jianweizou/fun/doc/電源接頭的位置按要上移6.4MM 右移3.85MM     image007.png

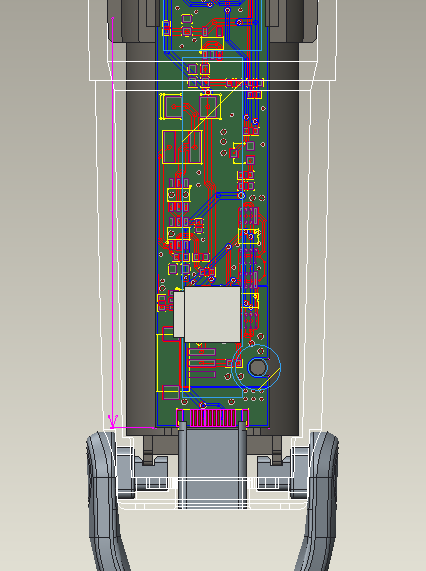
doc/電源接頭的位置按要上移6.4MM 右移3.85MM image007.png
