jianweizou/fun/README.md

# fun
fun

list:
20190226：
1、电源睡眠后电流大，4mA，电流大是由于AMS1117-33 LDO消耗大，需要替换为低功耗的
2、线路图中电池电压检测分压电阻是1：2
3、U7要去掉？
