jianweizou/fun/code/sonix evb/3.SN7312_IIC_OLED/src/29512885_1493619394BfCq.png

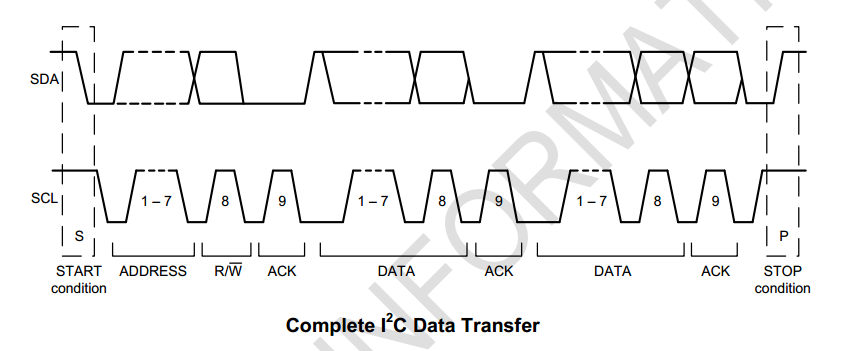
code/sonix evb/3.SN7312_IIC_OLED/src/29512885_1493619394BfCq.png
