jianweizou/fun/doc/fan 20181207/USB TYPE C 3.1母座夹板间距1.0MM 长度10.5MM工程图.jpg

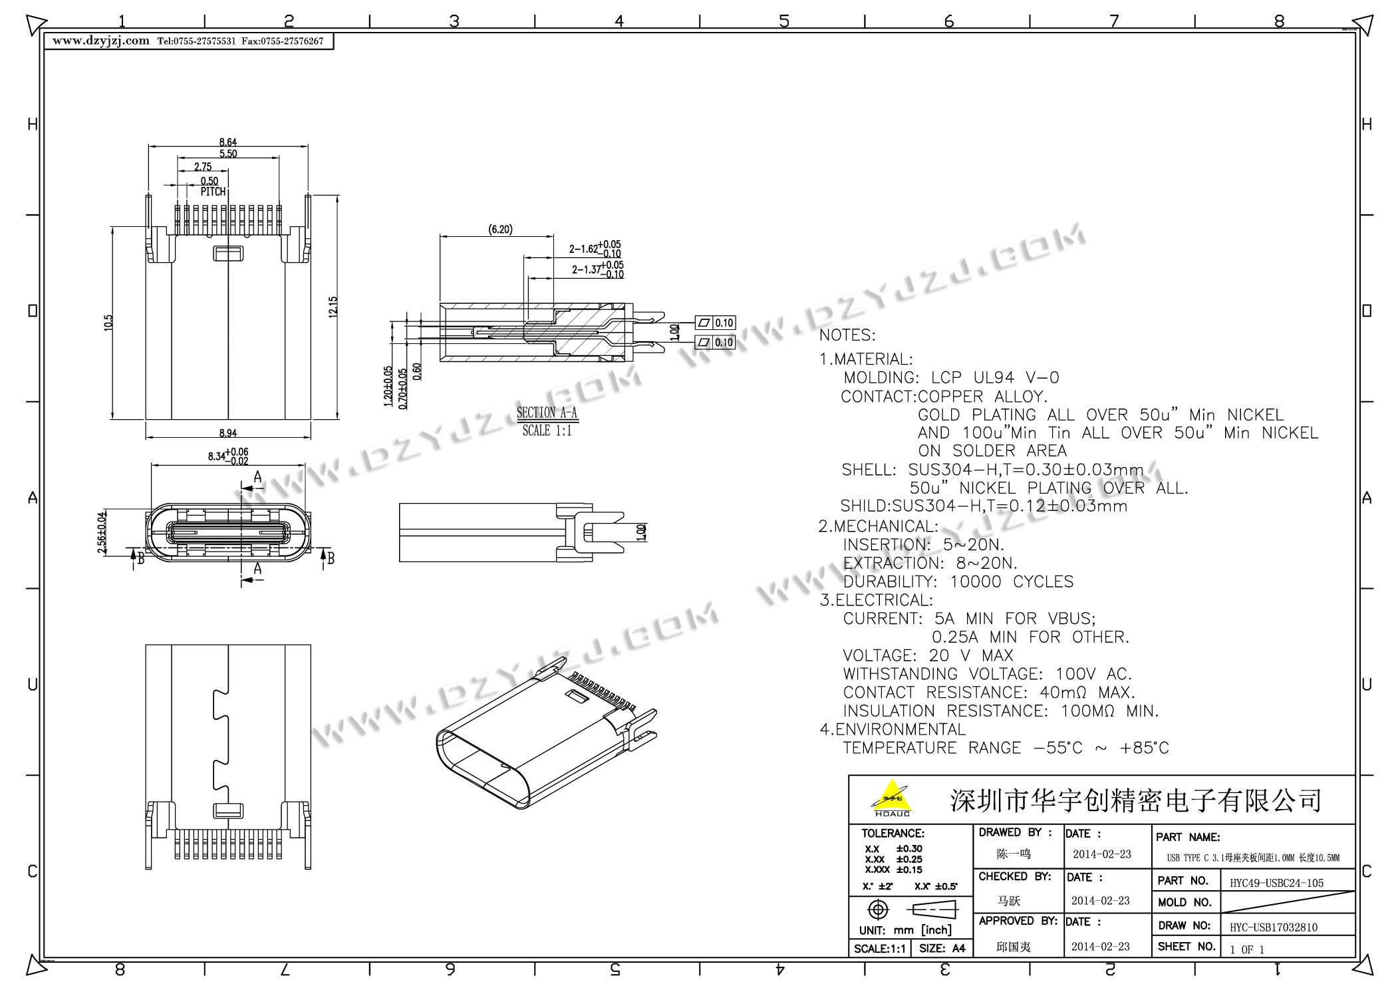
doc/fan 20181207/USB TYPE C 3.1母座夹板间距1.0MM 长度10.5MM工程图.jpg
