jianweizou/fun/doc/FAN/image001.png

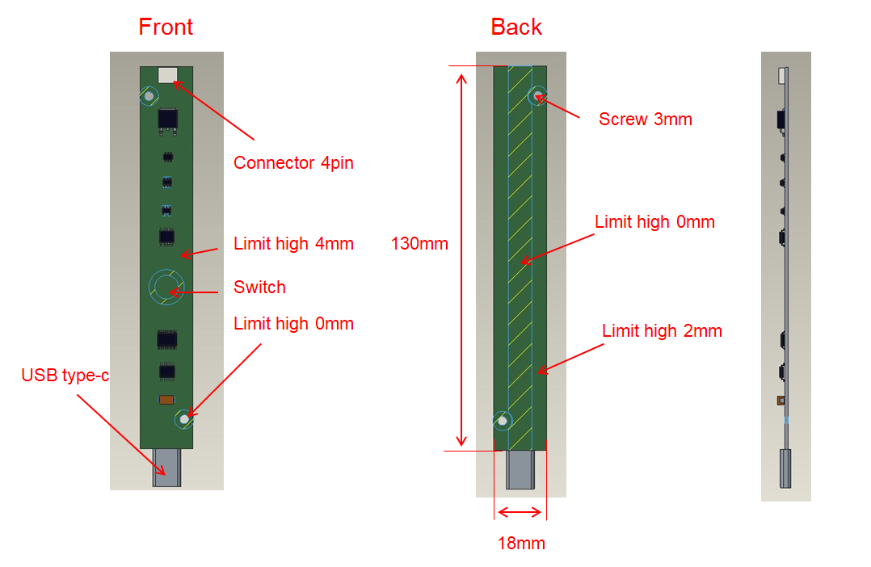
doc/FAN/image001.png
