jianweizou/fun/doc/image001.png

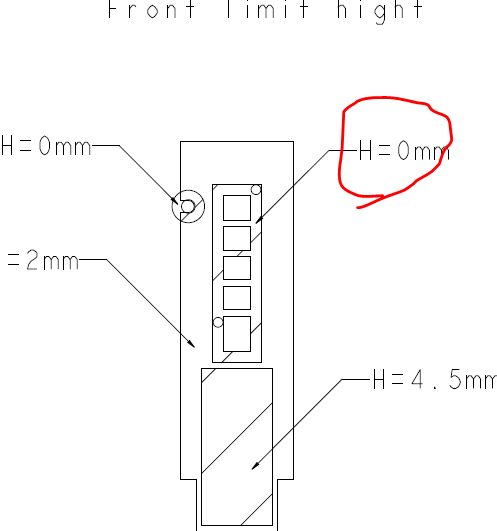
doc/image001.png
