jianweizou/fun/doc/image002.png

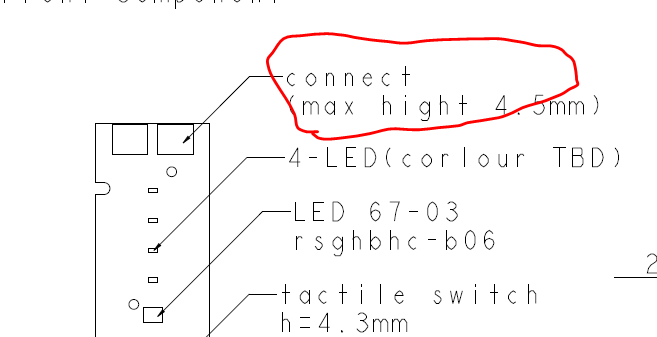
doc/image002.png
