jianweizou/fun/doc/左上角的螺絲孔跟零件有重疊要閃開image008.png

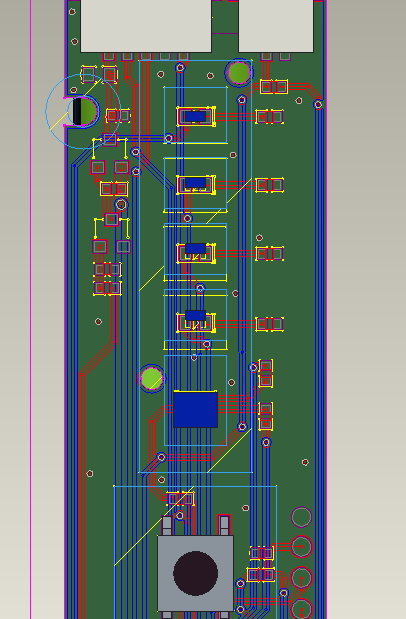
doc/左上角的螺絲孔跟零件有重疊要閃開image008.png
