jianweizou/fun/layout/风扇_V1.9_20190731/风扇_V1.9.xls

风扇_V1.8
Comment | Designator | Footprint | Quantity | Name
47uF | C1, C3 | C-0603 | 2
22uF | C2, C6, C7 | C-0603 | 3
4.7uF | C4 | C-0402 | 1
1uF | C5, C8, C9, C11, C12 | C-0402 | 5
0.1uF | C10 | C-0402 | 1
10K | R1, R3, R4, R27, R28, R30, R31, R32, R33 | R-0402 | 9 | 贴片电阻
60K | R2 | R-0402 | 1
1K | R5,R8 | R-0402 | 2
330R | R6, R11 | R-0402 | 2
0.1R | R7 | R-0402 | 1
470K | R9 | R-0402 | 1
4.7K | R10 | R-0402 | 1
2K | R12 | R-0402 | 1
500R | R15, R16, R17, R18, R19, R20, R21 | R-0402 | 7
47K | R22, R23, R26 | R-0402 | 3
500K | R25 | R-0402 | 1
1M | R24 | R-0402 | 1
20K | R29 | R-0402 | 1
LED0 | D1, D3, D4, D5 | LED-0603 | 4 | 贴片LED
LED | D2 | 0603 RGB-LED | 1 | RGB 共阴 LED | 封装参考：https://item.taobao.com/item.htm?id=577033877168&ns=1&abbucket=5
10uH 1A or 2A | L1 | L-SMD | 1 | 贴片电感（4*4*2mm）
TU1501WNR-5PS-VOID-C0-NL-A | P2 | TU1501WNR-5PS-VOID-C0-NL-A | 1 | TU1501WNR-5PS-VOID-C0-NL-A | 封装参考：http://www.tyu.com.tw/en/search_detail.php?cid=1&cid2=3&cid3=8&nid=50&s_ok2=2&Page=0
TU1501WNR-3PS-VOID-C0-NL-A | P1 | TU1501WNR-3PS-VOID-C0-NL-A | 1 | TU1501WNR-3PS-VOID-C0-NL-A | 封装参考：http://www.tyu.com.tw/en/search_detail.php?cid=1&cid2=3&cid3=8&nid=50&s_ok2=2&Page=0
TU1501WNR-2PS-VOID-C0-NL-A | P3 | TU1501WNR-2PS-VOID-C0-NL-A | 1 | TU1501WNR-2PS-VOID-C0-NL-A | 封装参考：http://www.tyu.com.tw/en/search_detail.php?cid=1&cid2=3&cid3=8&nid=50&s_ok2=2&Page=0
8050 | Q1, Q3, Q6, Q7 | SOT-23 | 4 | 8050 NPN 三极管
BM2301 | Q2, Q4 | SOT-23 | 2 | BM2312 PMOS
8550 | Q5 | SOT-23 | 1
SW-PB | S1 | SWITHCH-4P-SMT | 1 | 四角按键6*6*4.3mm
TPS76033DBVR | U4 | SOT-223 | 1 | IC
USB Type-C | U5 | USB-type C | 1 | USB-type C
N76E003AQ20 | U6 | QFN-20 0.4mm | 1 | IC
HY2120-CB | U1 | SOT-23-6L | 1 | HY2120
HM4033 | U2 | SOT-23-6L | 1 | HM4033
8205A | U3 | TSSOP8 | 1 | 8205A
HM8205-6 | U8 | SOT-23-6L | 1 | HM8205-6
SS34 | D6 | DSMD | 1 | SS34 二极管 | 注意方向
