jianweizou/fun/doc/to 鄒生 main_board_pcb_20190411_v3.dxf

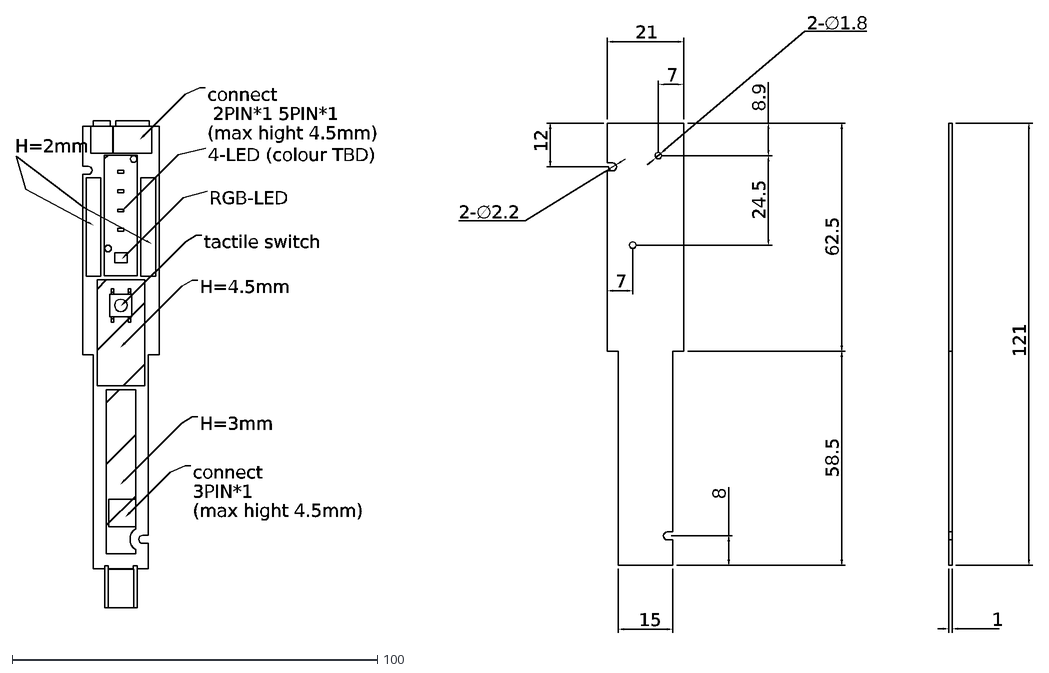
[picture p9: CAD file, 2019-05-01]
doc/to 鄒生 main_board_pcb_20190411_v3.dxf
21
12
8
15
121
62.5
58.5
2-∅1.8
8.9
24.5
7
1
2-∅2.2
connect
2PIN*1 5PIN*1
(max hight 4.5mm)
4-LED (colour TBD)
tactile switch
RGB-LED
H=3mm
H=4.5mm
H=2mm
3PIN*1
