jianweizou/fun/layout/风扇_V1.4_20190213/风扇_V1.4.DXF

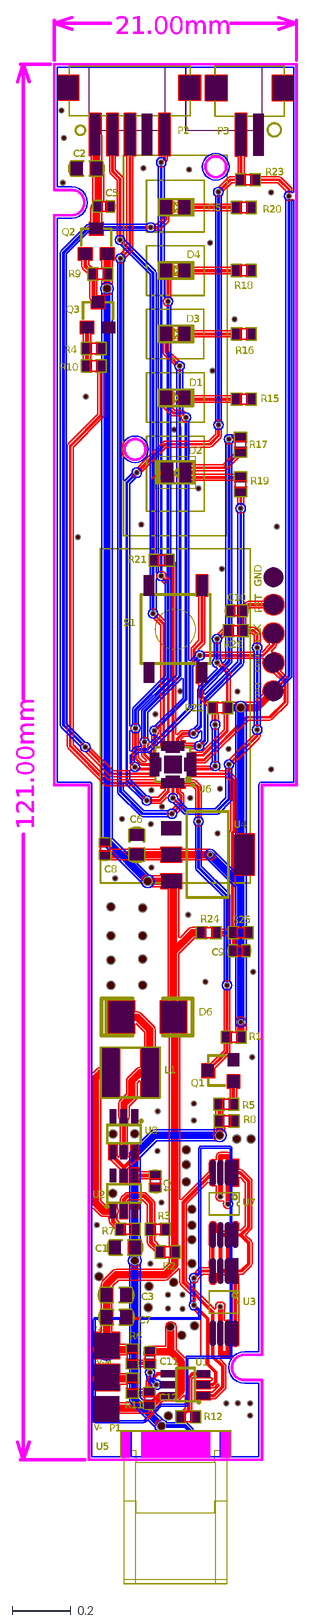
[picture p10: CAD file, 2019-02-16]
layout/风扇_V1.4_20190213/风扇_V1.4.DXF
DAT
BAT
CLK
RST
GND
V+
V-
V-M
21.00mm
121.00mm
U6
U5
U4
U3
U2
U1
S1
R26
R25
R24
R23
R22
R21
R20
R19
R18
R17
R16
R15
R12
R11
R10
R9
R8
R6
R5
R4
R3
R2
R1
Q1
P3
P2
P1
L1
D2
C10
C9
C8
C7
C6
C5
C4
C3
C2
C1
D1
D3
D4
D5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
