jianweizou/fun/layout/风扇_V1.6_20190413/风扇_V1.DXF

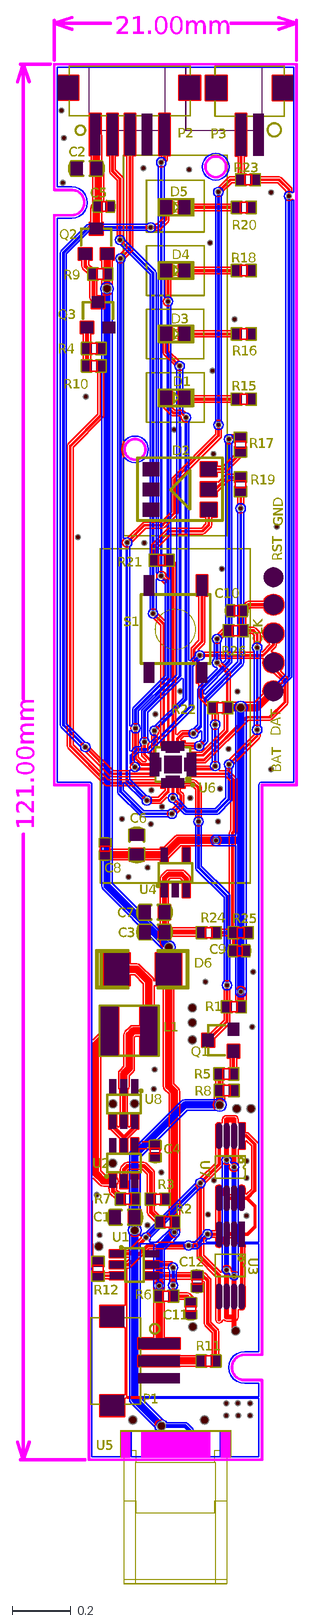
[picture p12: CAD file, 2019-04-13]
layout/风扇_V1.6_20190413/风扇_V1.DXF
GND
RST
CLK
BAT
DAT
121.00mm
21.00mm
U8
U7
Q3
Q2
D6
C12
C11
R7
D5
D4
D3
D1
C1
C2
C3
C4
C5
C6
C7
C8
C9
C10
D2
L1
P1
P2
P3
Q1
R1
R2
R3
R4
R5
R6
R8
R9
R10
R11
R12
R15
R16
R17
R18
R19
R20
R21
R22
R23
R24
R25
R26
S1
U1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
