jianweizou/fun/layout/风扇_V1.9_20190731/风扇_V1.9.DXF

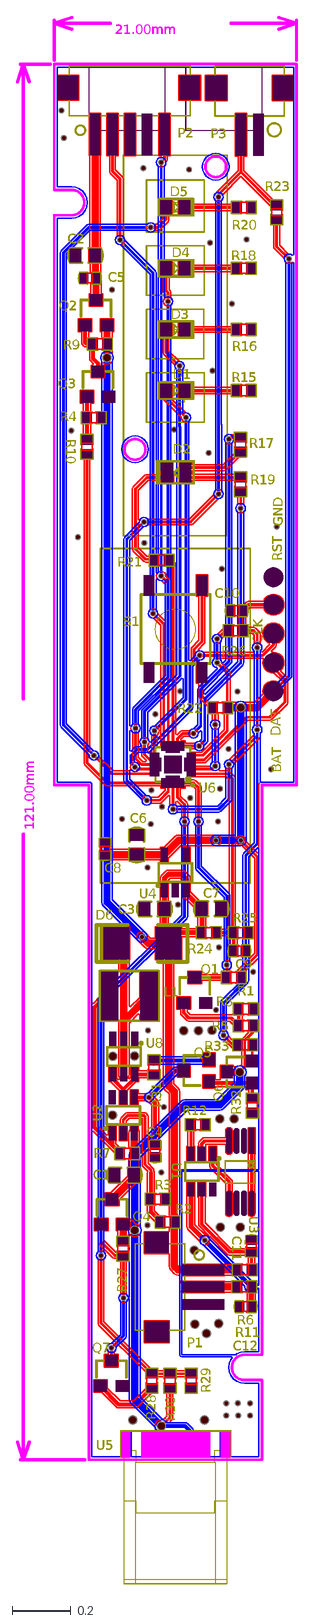
[picture p15: CAD file, 2019-09-28]
layout/风扇_V1.9_20190731/风扇_V1.9.DXF
DAT
BAT
CLK
RST
GND
21.00mm
121.00mm
Q7
R33
R32
R31
Q6
Q5
R30
R29
R28
R27
Q4
R6
C12
U6
U5
U4
U3
U2
U1
S1
R26
R25
R24
R23
R22
R21
R20
R19
R18
R17
R16
R15
R12
R11
R10
R9
R8
R5
R4
R3
R2
R1
Q1
P3
P2
P1
L1
D2
C10
C9
C8
C7
C6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
