jianweizou/fun/(list of files, cad)

Other CAD files:
code/fun_20180702/Output/main.obj
doc/fan 20181207/main_board_pcb_v1.dxf
doc/main_board_pcb_v1with 2CNTand 3pad.dxf
code/fun_20180702/Output/motor.obj
code/fun_20180702/Output/key.obj
code/fun_20180702/Output/led.obj
code/fun_20180702/Output/STARTUP.obj
code/fun_20180702/Output/PUTCHAR.obj
