jianweizou/fun/layout/风扇_V1.8_20190429/风扇_V1.8.pdf

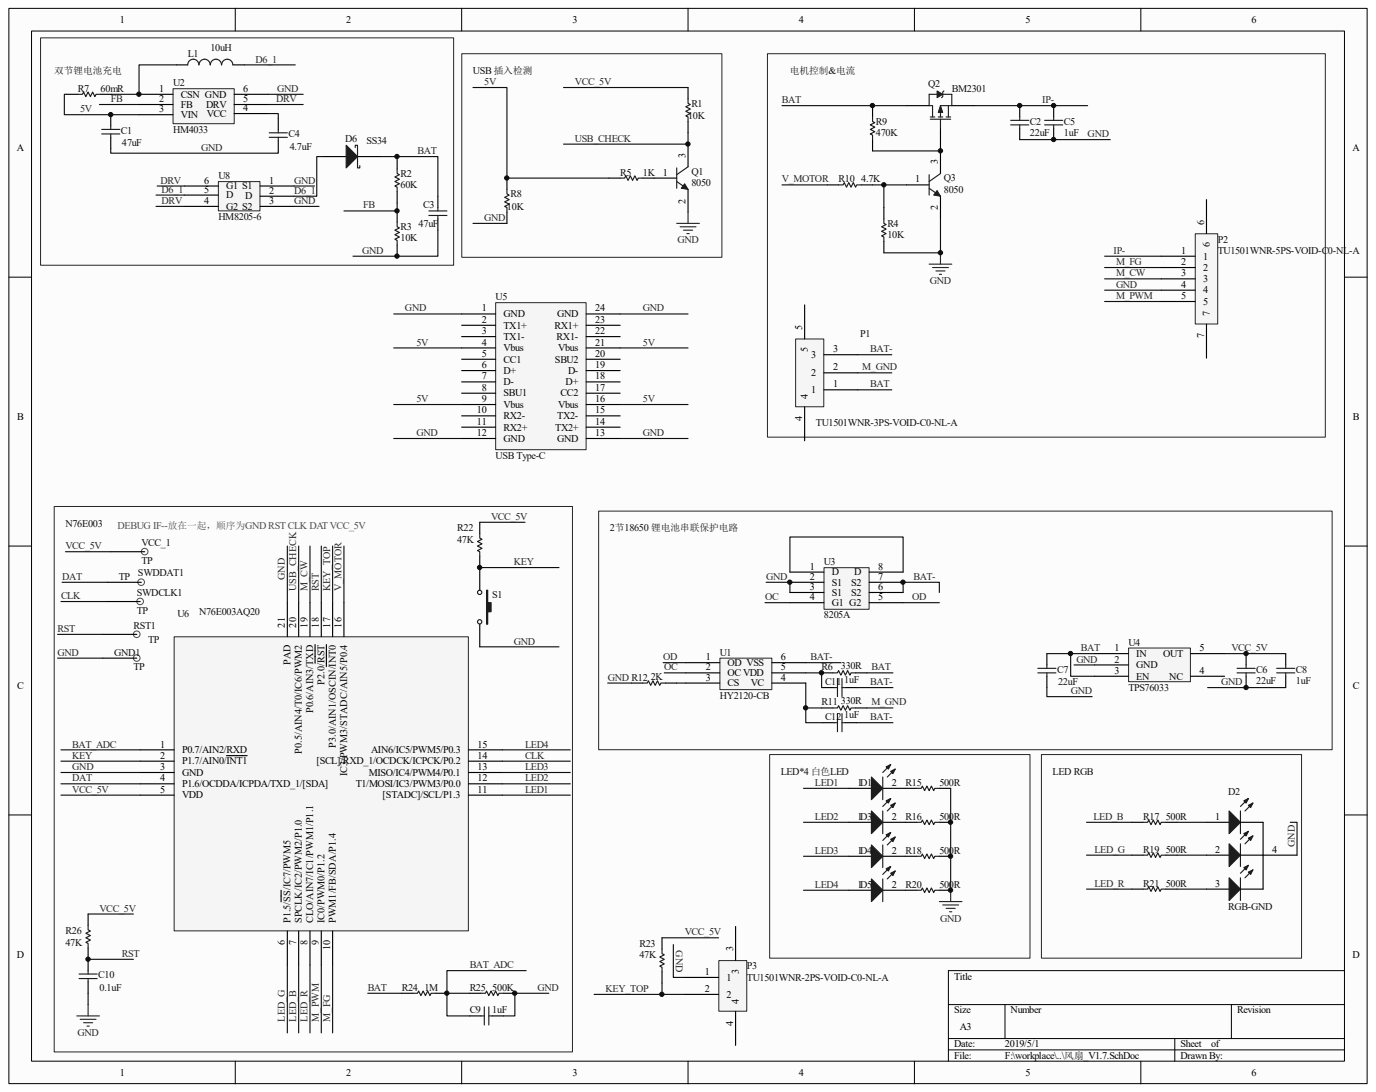
[picture p19: page 1]

IP- P⁰.5/AIN⁴/T⁰/IC⁶/PWM² ²⁰ P⁰.6/AIN³/TXD ¹⁹

DEBUG IF--放在一起，顺序为GND RST CLK DAT VCC_5V
VCC_1
