jianweizou/fun/doc/fan 20181207/main_board_pcb_v1.pdf

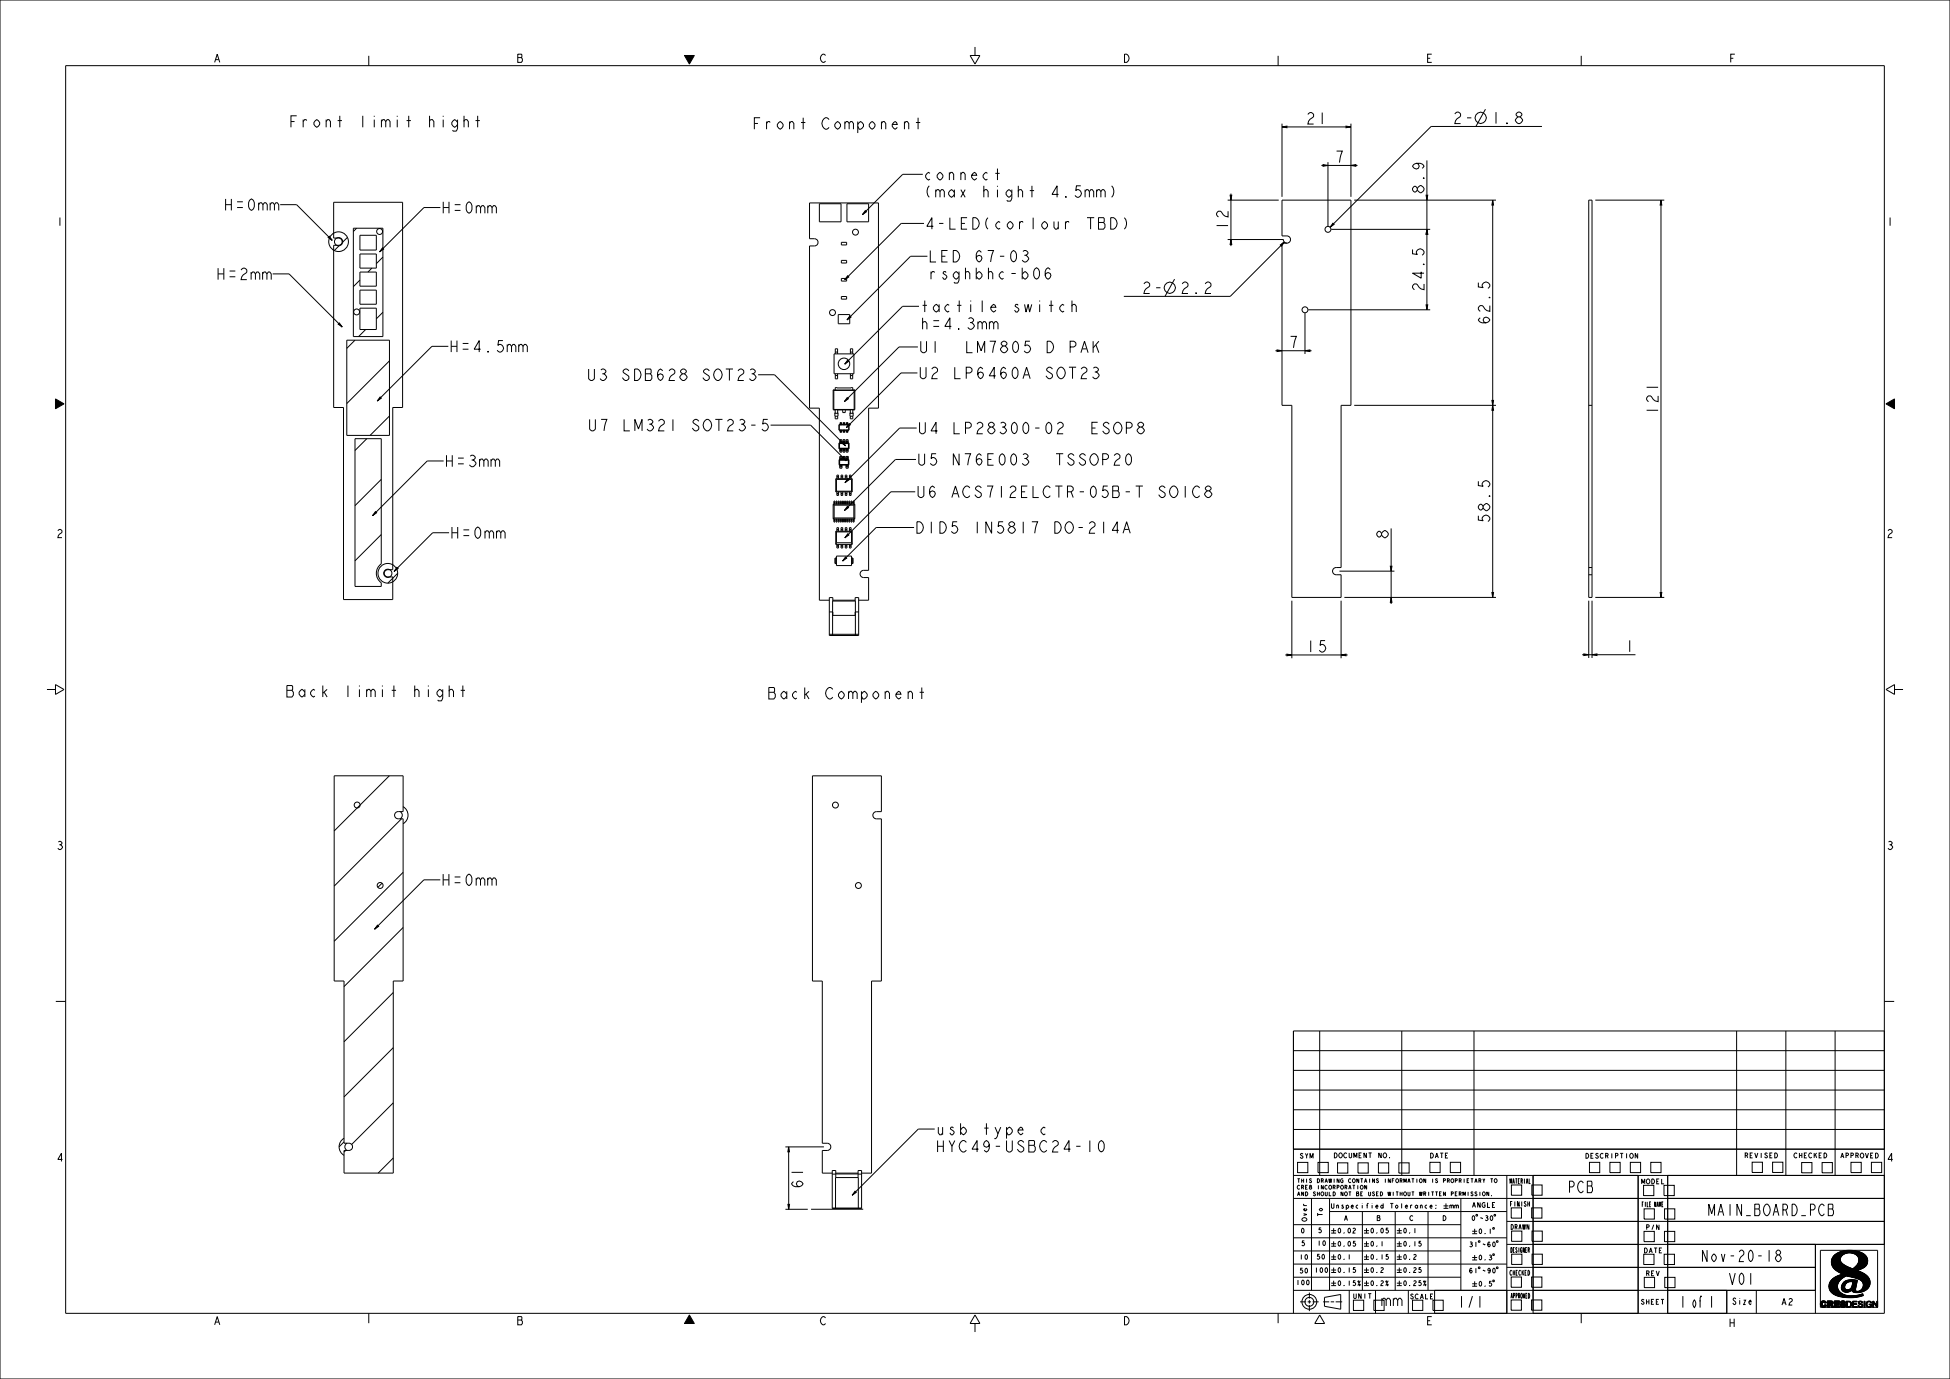
[picture p21: page 1]
Unspecified Tolerance: #-; ANGLE; F Over; DESIGNER; APPROVED; CHECKED; FINISH; MATERIAL; FILE NAME; MODEL; SHEET; DATE; UNIT; SCALE; SYM; DOCUMENT; DESCRIPTION; REVISED; Front; limit hight; Back; limit; hight; usb type; HYC49-USBC24-10; connect; (max hight; 4-LED(corlour TBD); tactile; switch; h=4.3mm U1 LM7805 D PAK; U3 SDB628 SOT23; U2 LP6460A SOT23; U7 LM321 SOT23-5; U4 LP28300-02 ESOP8; U5 N76E003 TSSOP20 U6 ACS712ELCTR-05B-T SOIC8 D1D5 1N5817 DO-214A; Component; LED 67-03 rsghbhc-b06

THIS DRAWING CONTAINS INFORMATION IS PROPRIETARY TO CRE8 INCORPORATION AND SHOULD NOT BE USED WITHOUT WRITT EN PERMISSION. | PCB

MAIN_BOARD_PCB
Nov-20-18

5 | | | | | | | | 31$-
50
50 | | | | | | | 61$-

DRAWN | P/N

REV

Size
