jianweizou/fun/doc/TO 鄒生 main_board_pcb_20190411_v3.pdf

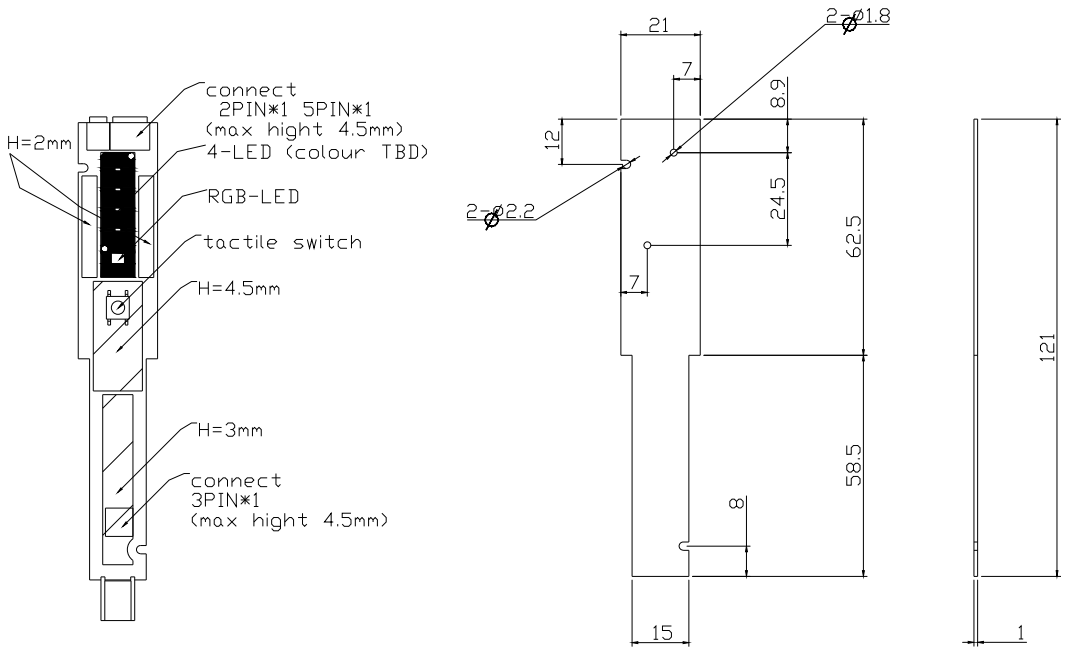
[picture p22: page 1]
