jianweizou/fun/doc/13H 12V Drawing.pdf

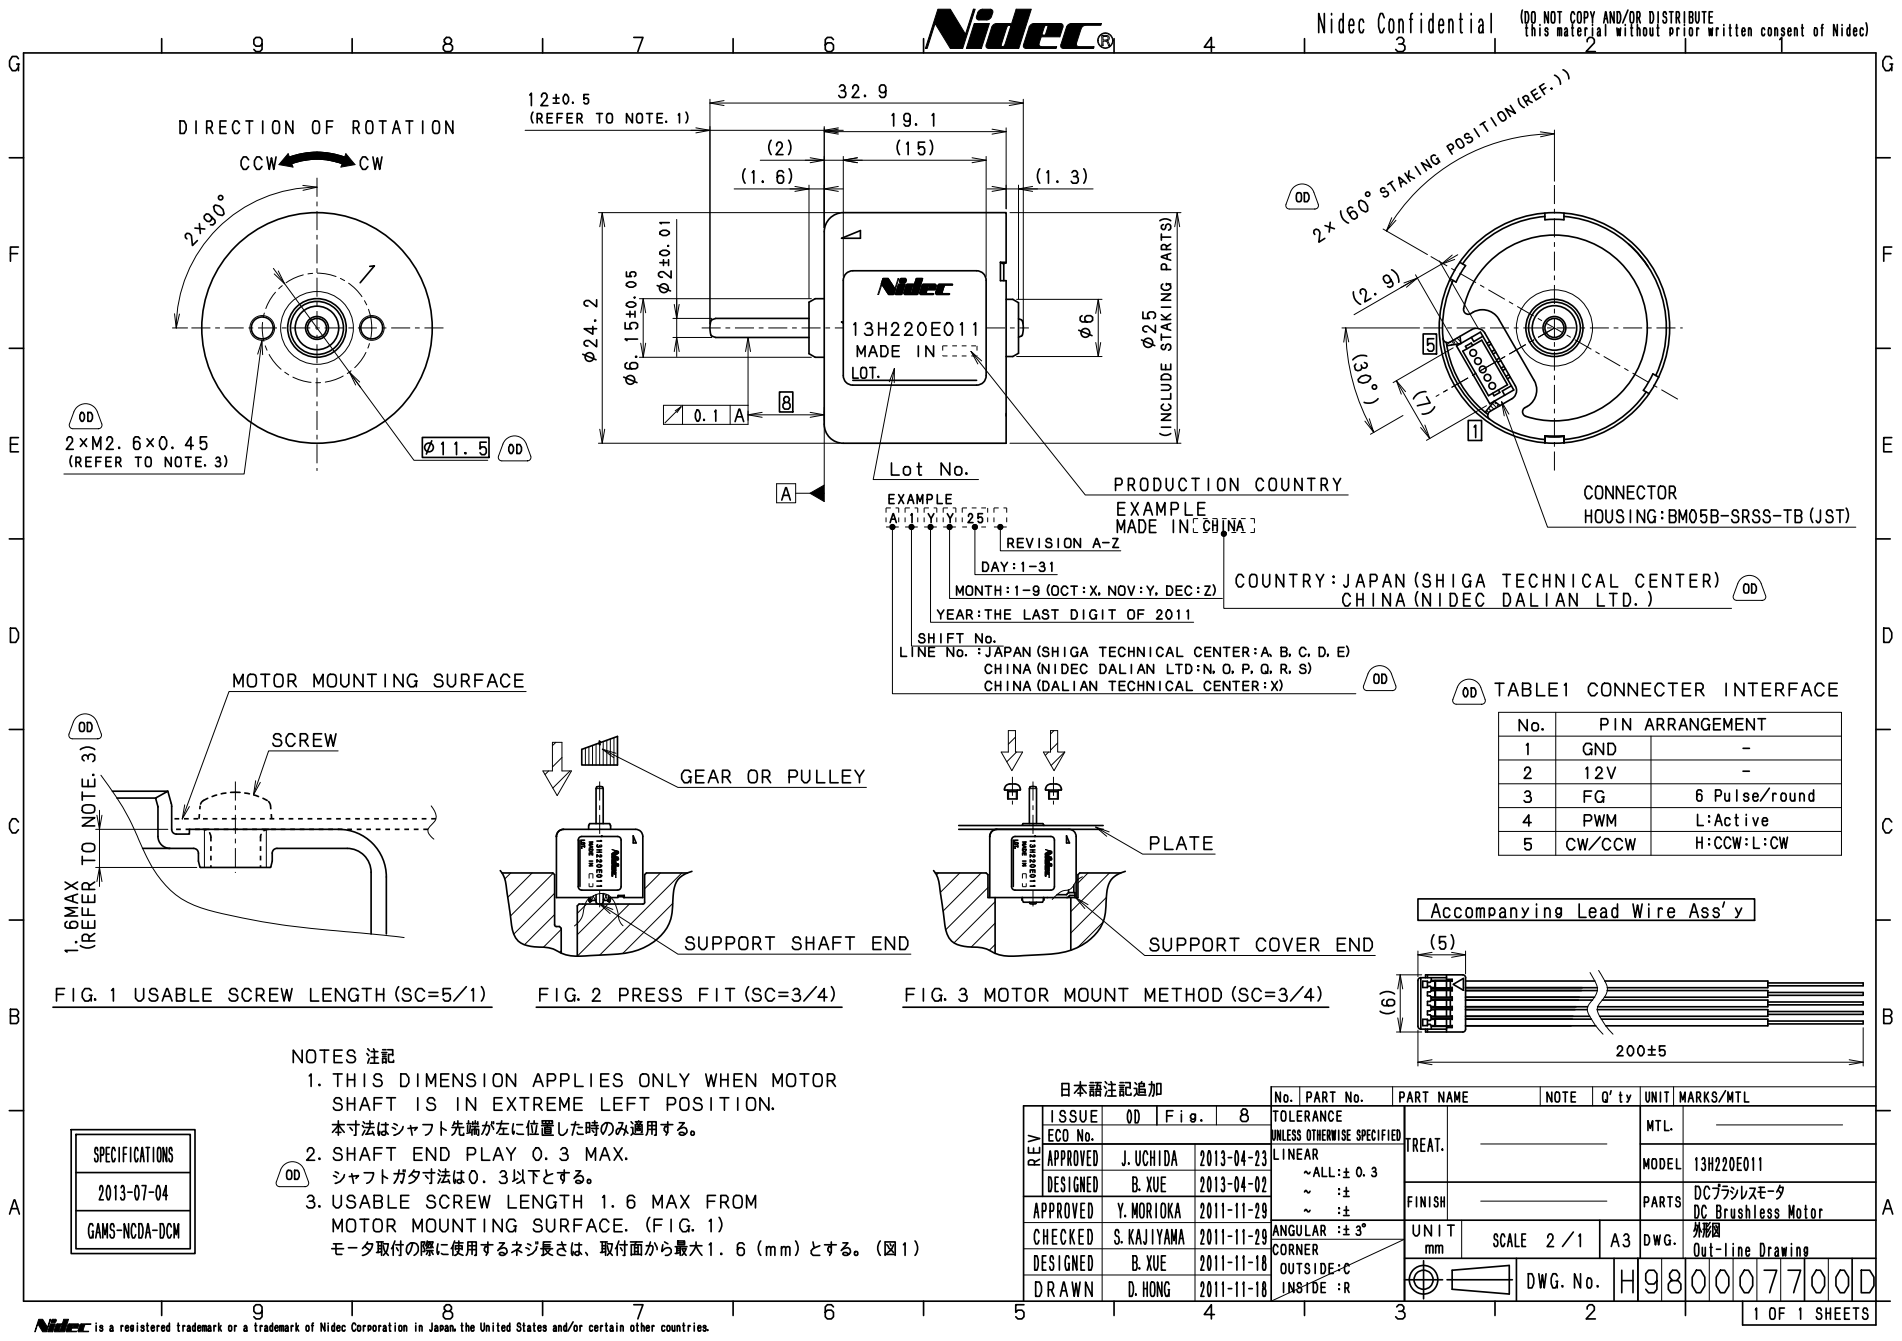
[picture p23: page 1]
