jianweizou/fun/doc/EN-TU1501HNO-NP-x.pdf

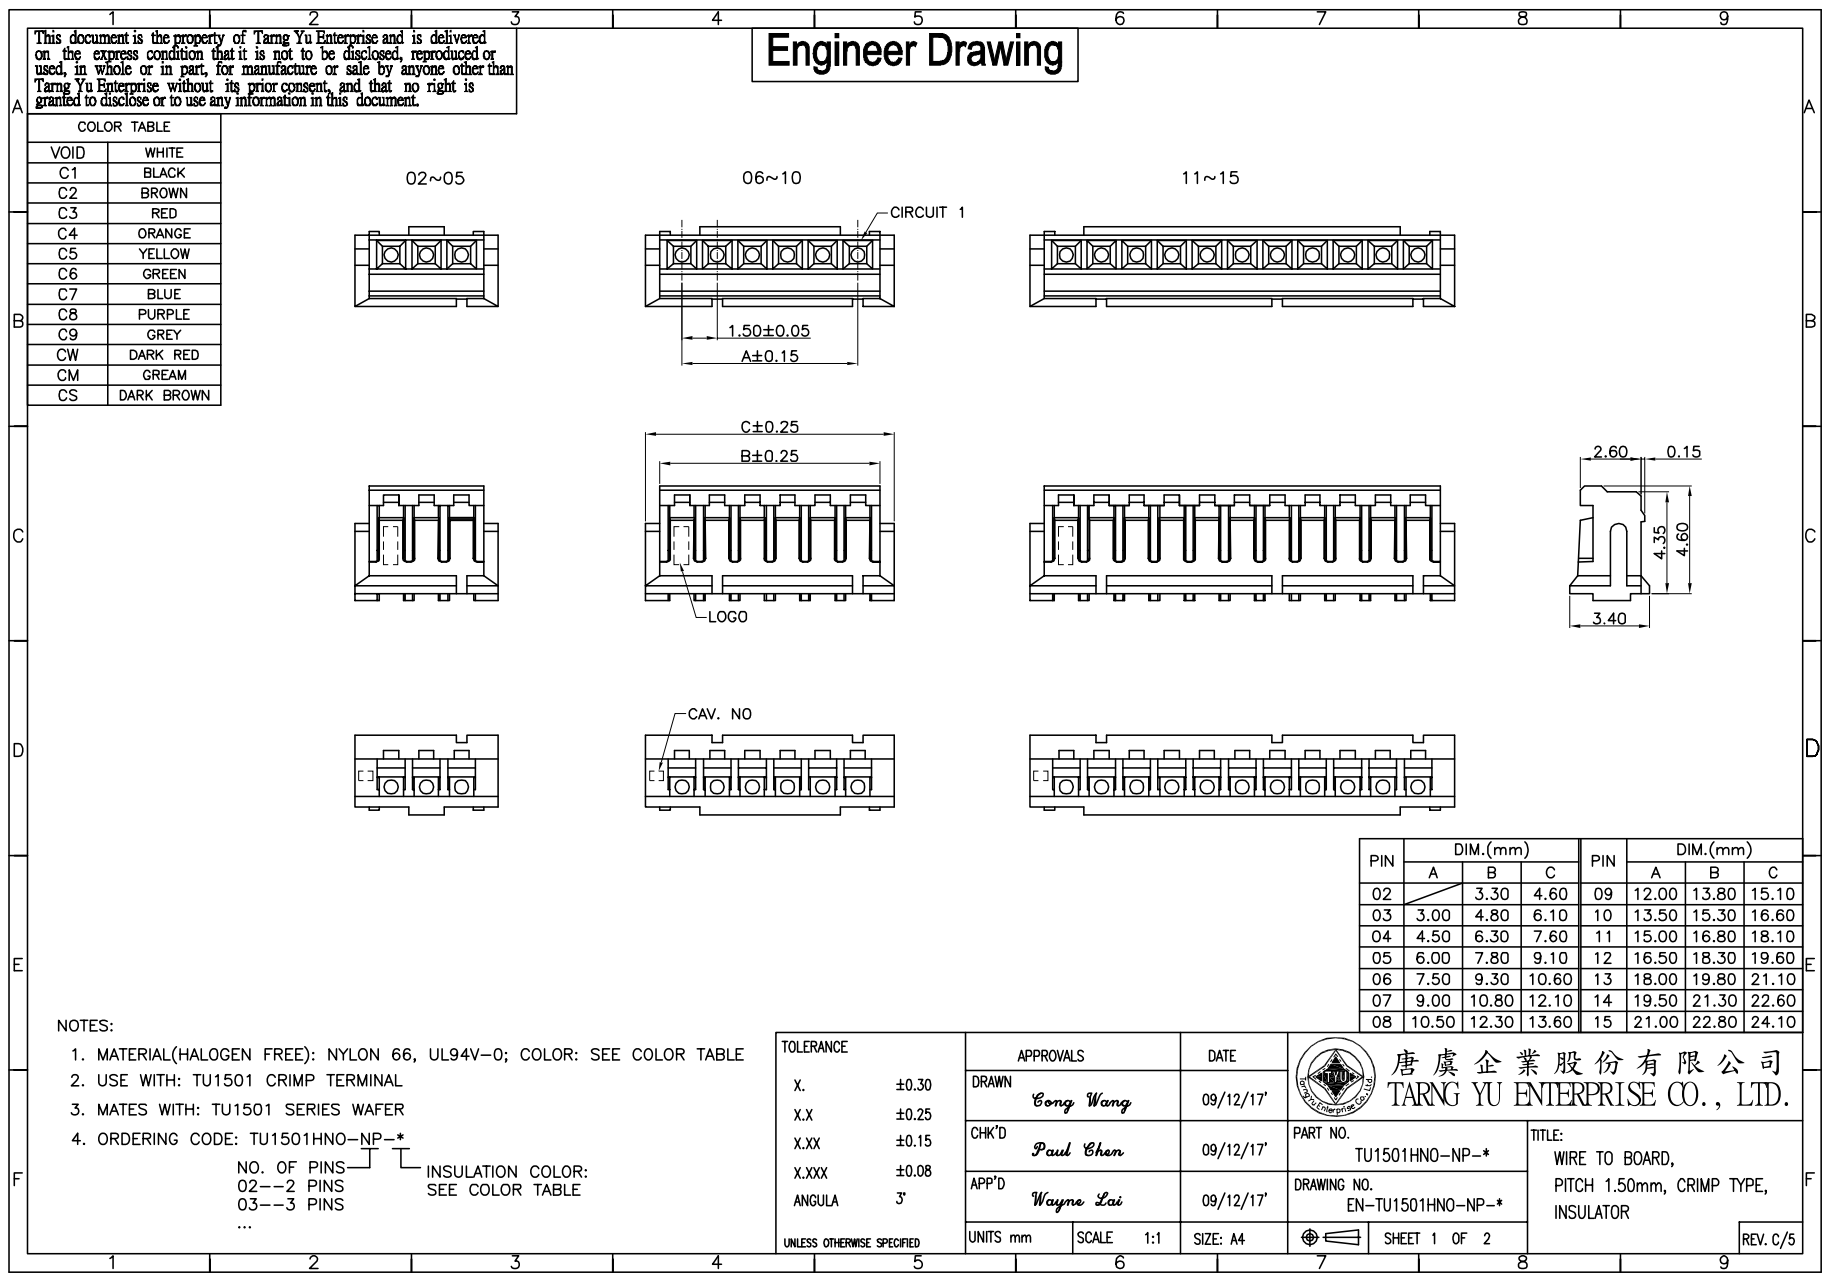
[picture p24: page 1]

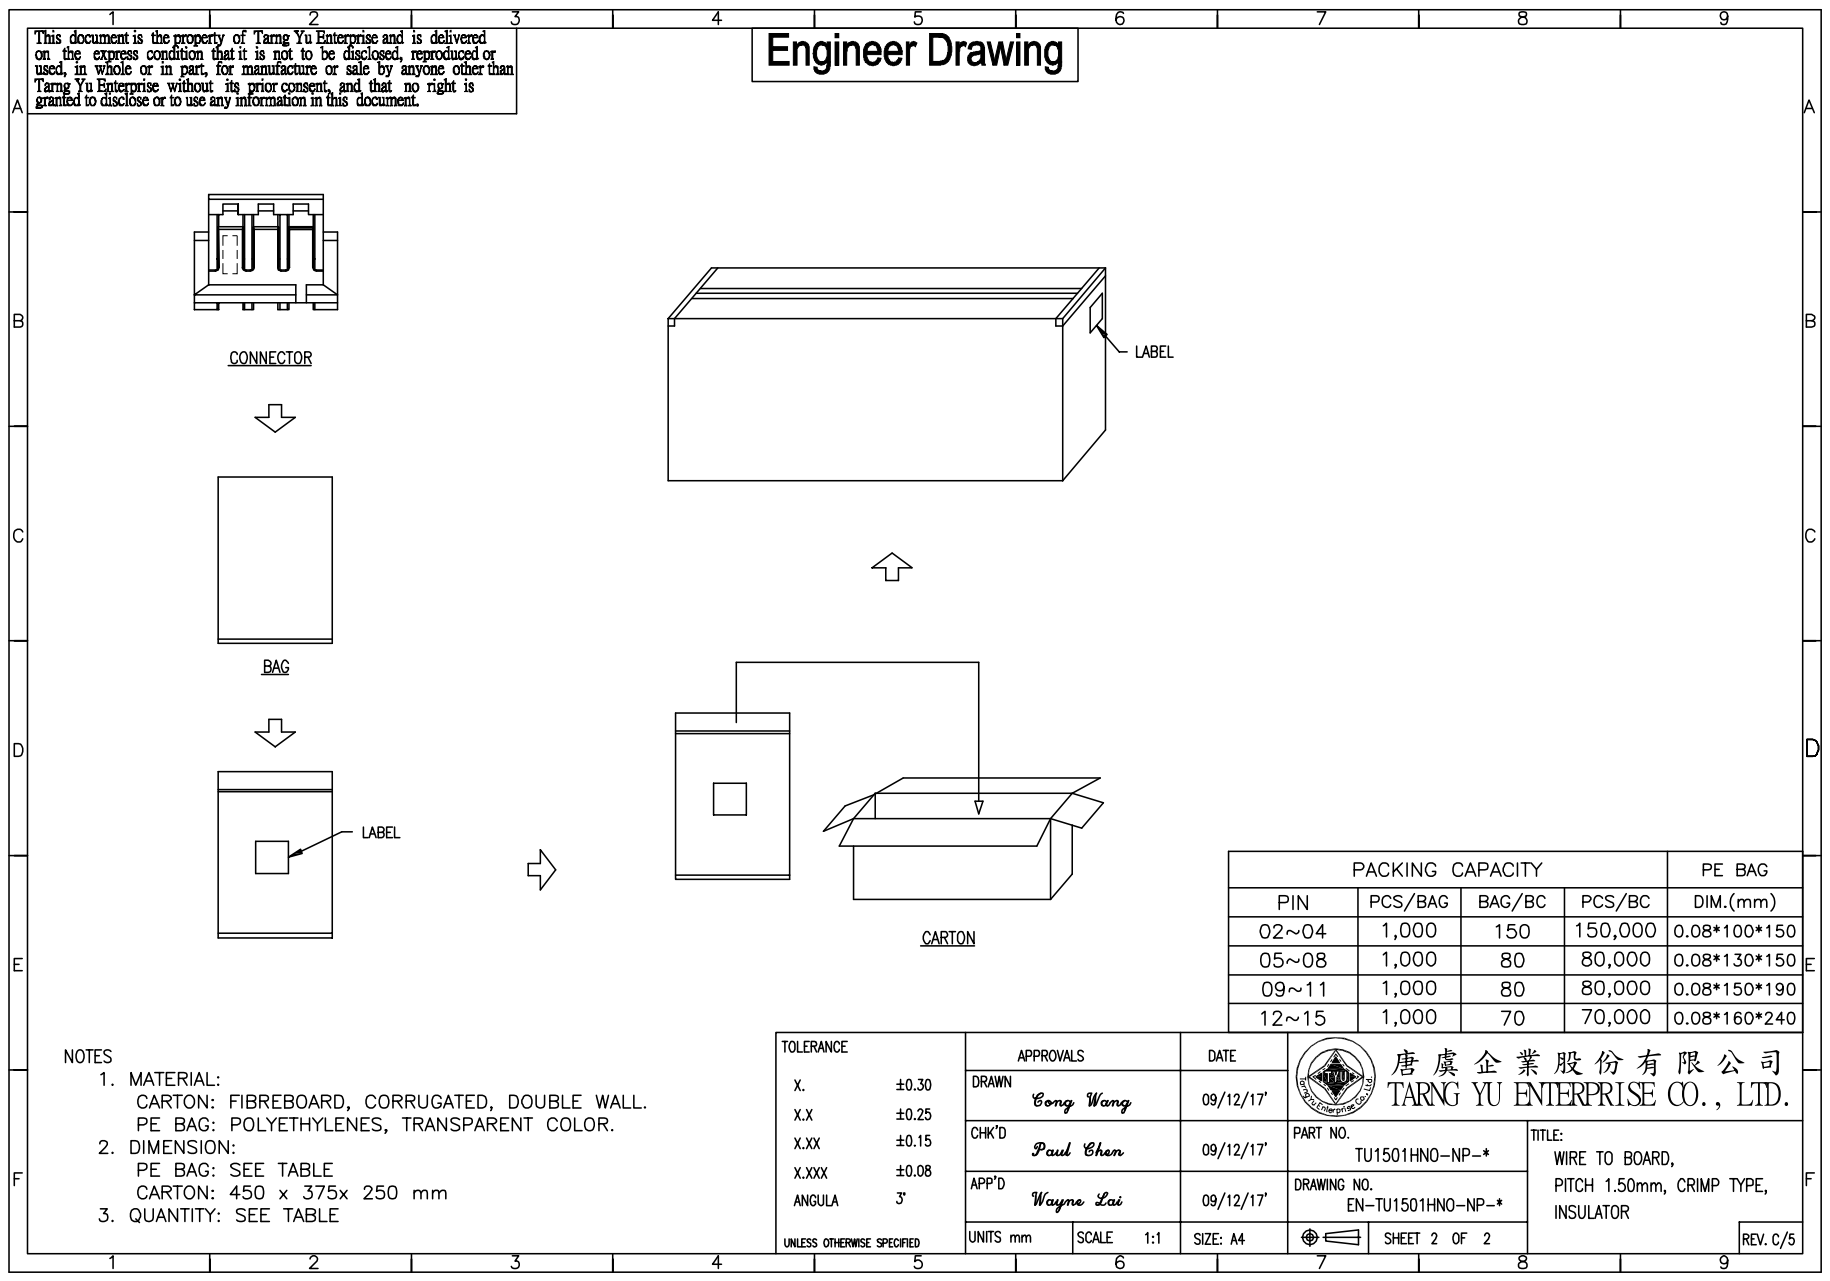
[picture p25: page 2]
