jianweizou/fun/doc/EN-TU1501TPx-x.pdf

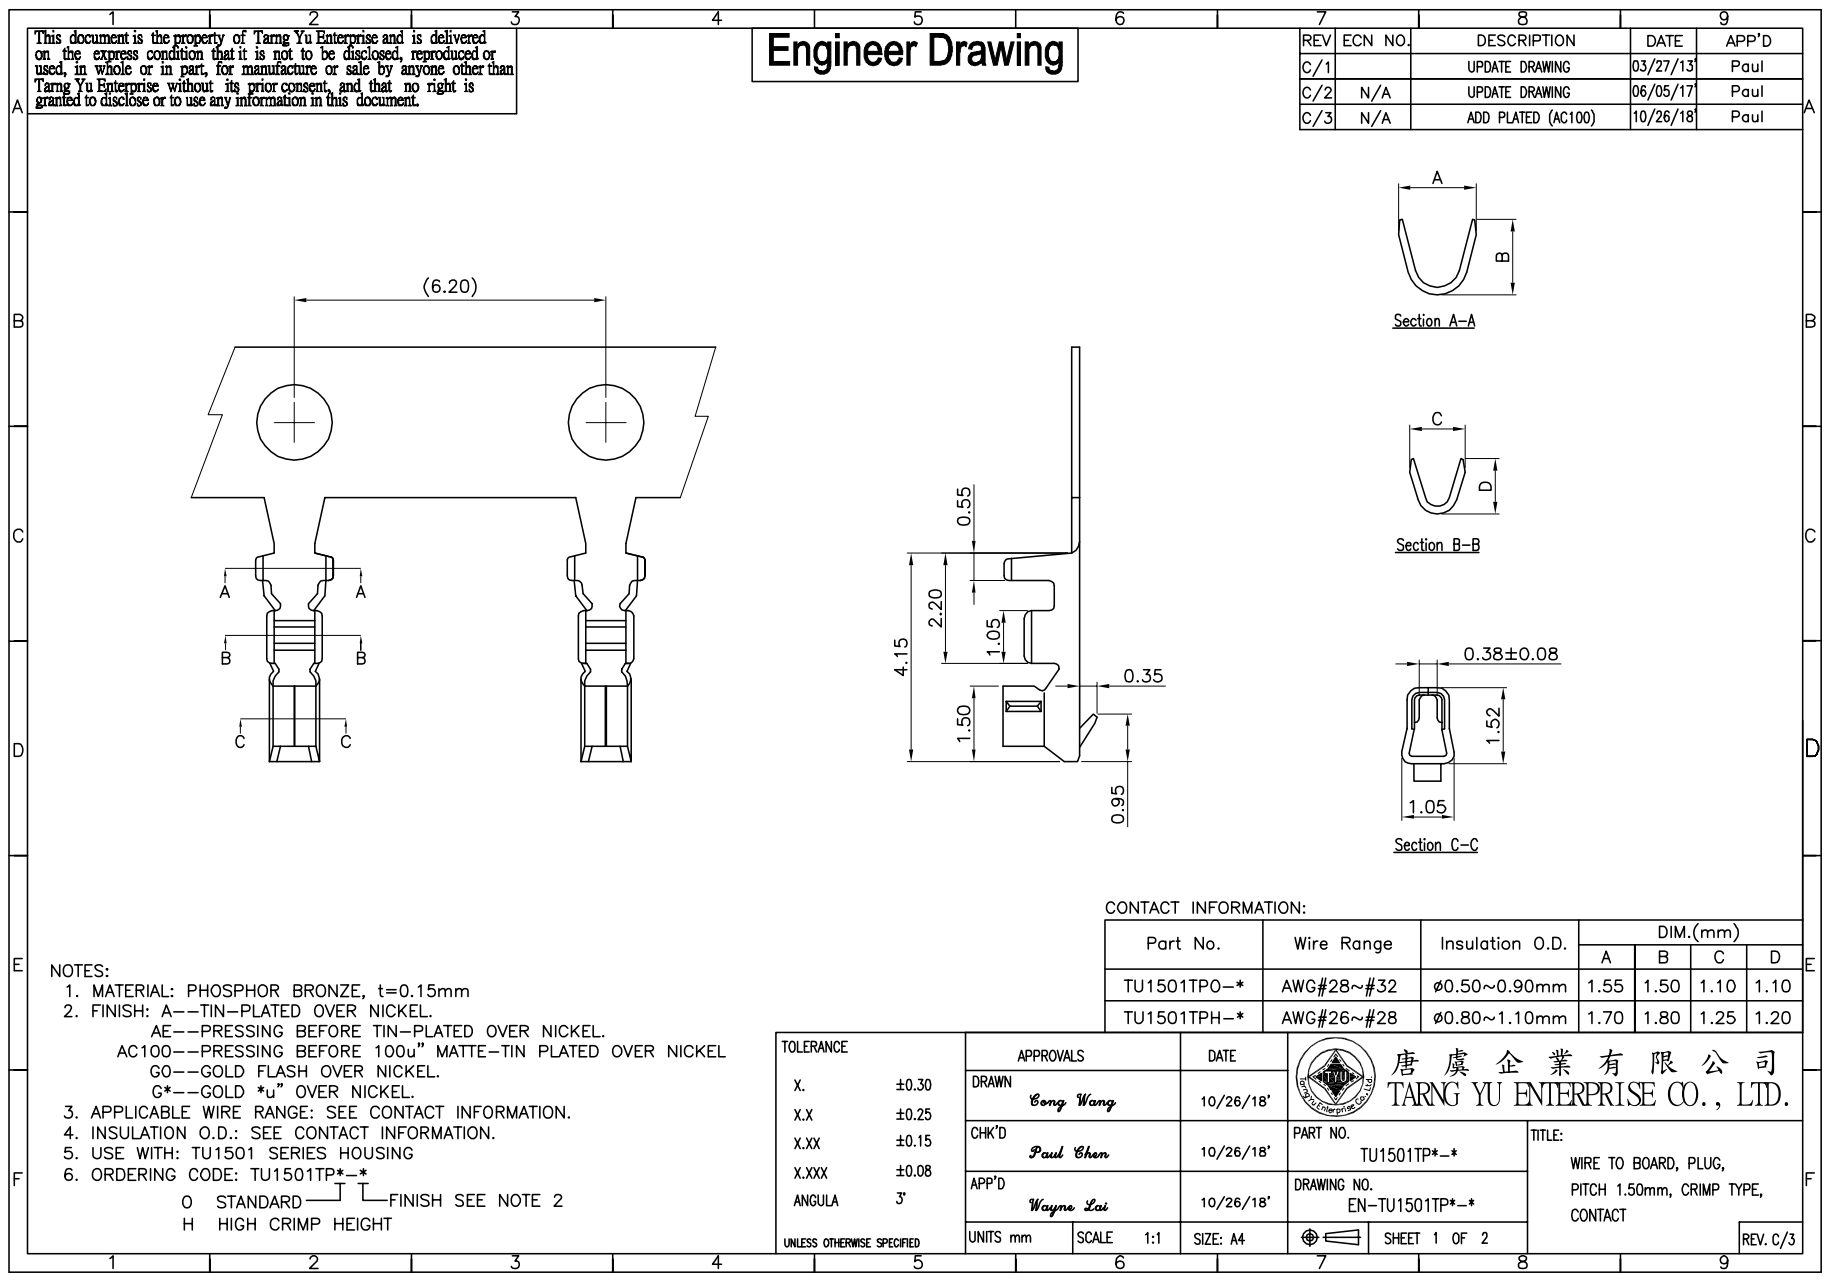
[picture p26: page 1]

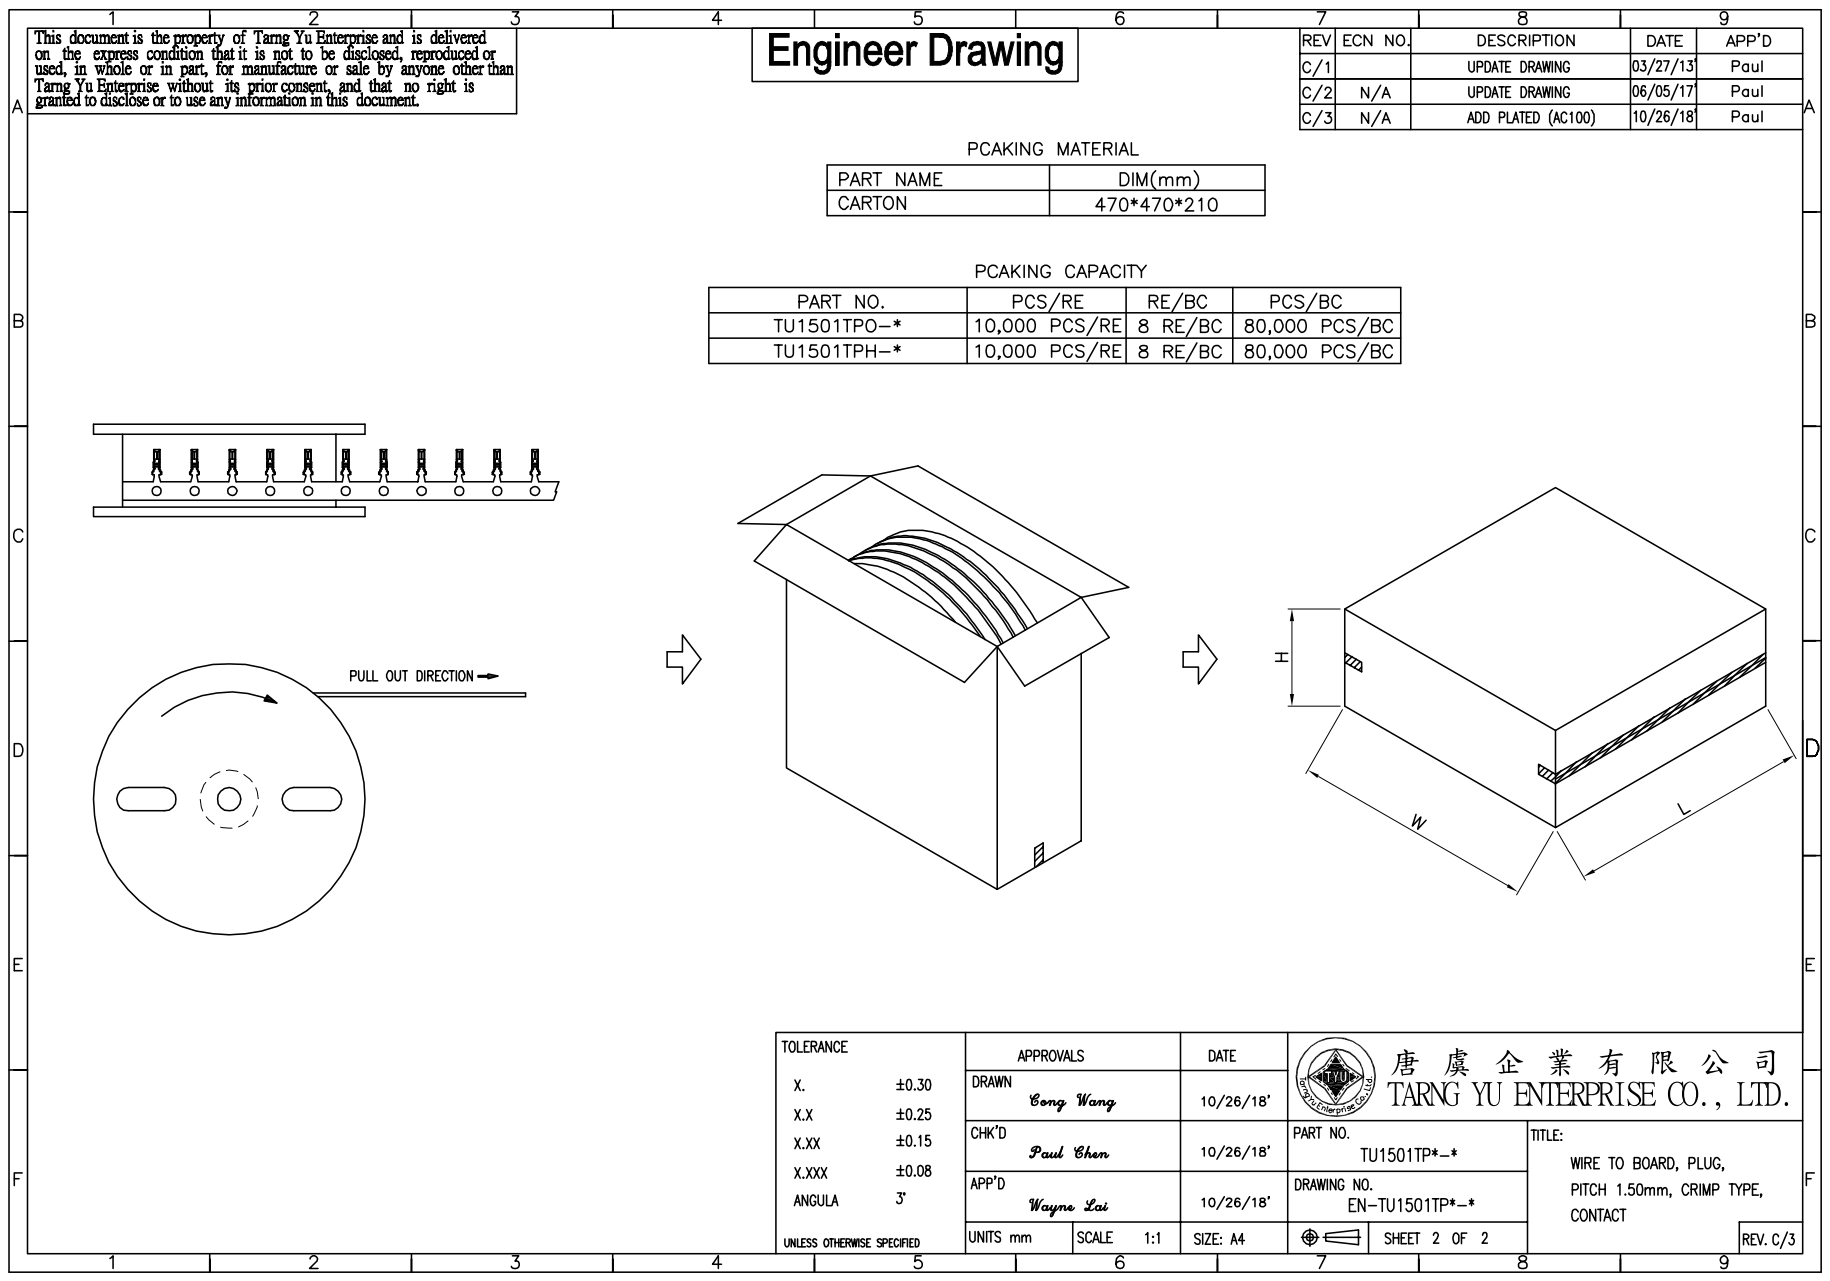
[picture p27: page 2]
