jianweizou/fun/doc/EN-TU1501WNR-NPS-x-x-NL-A.PDF

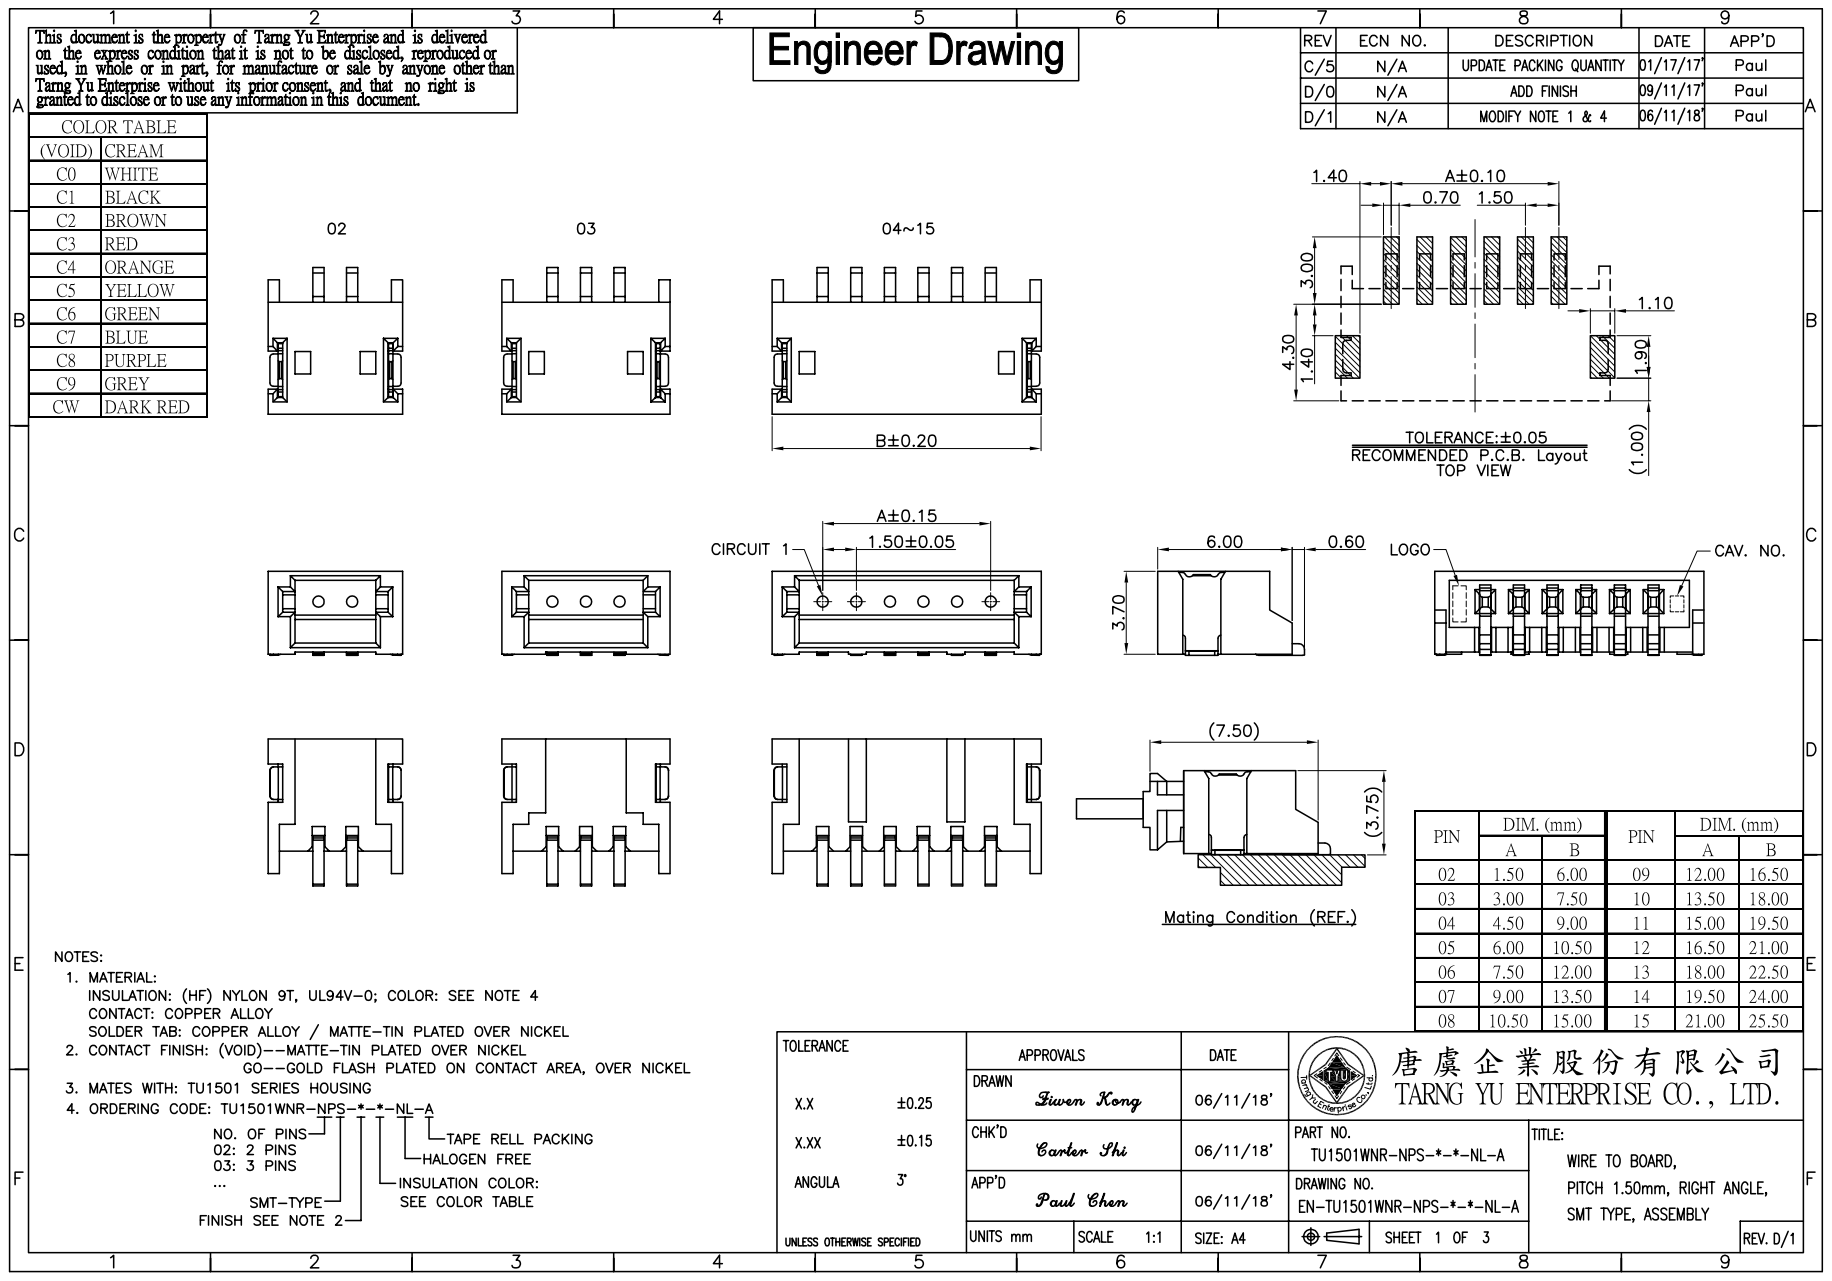
[picture p28: page 1]

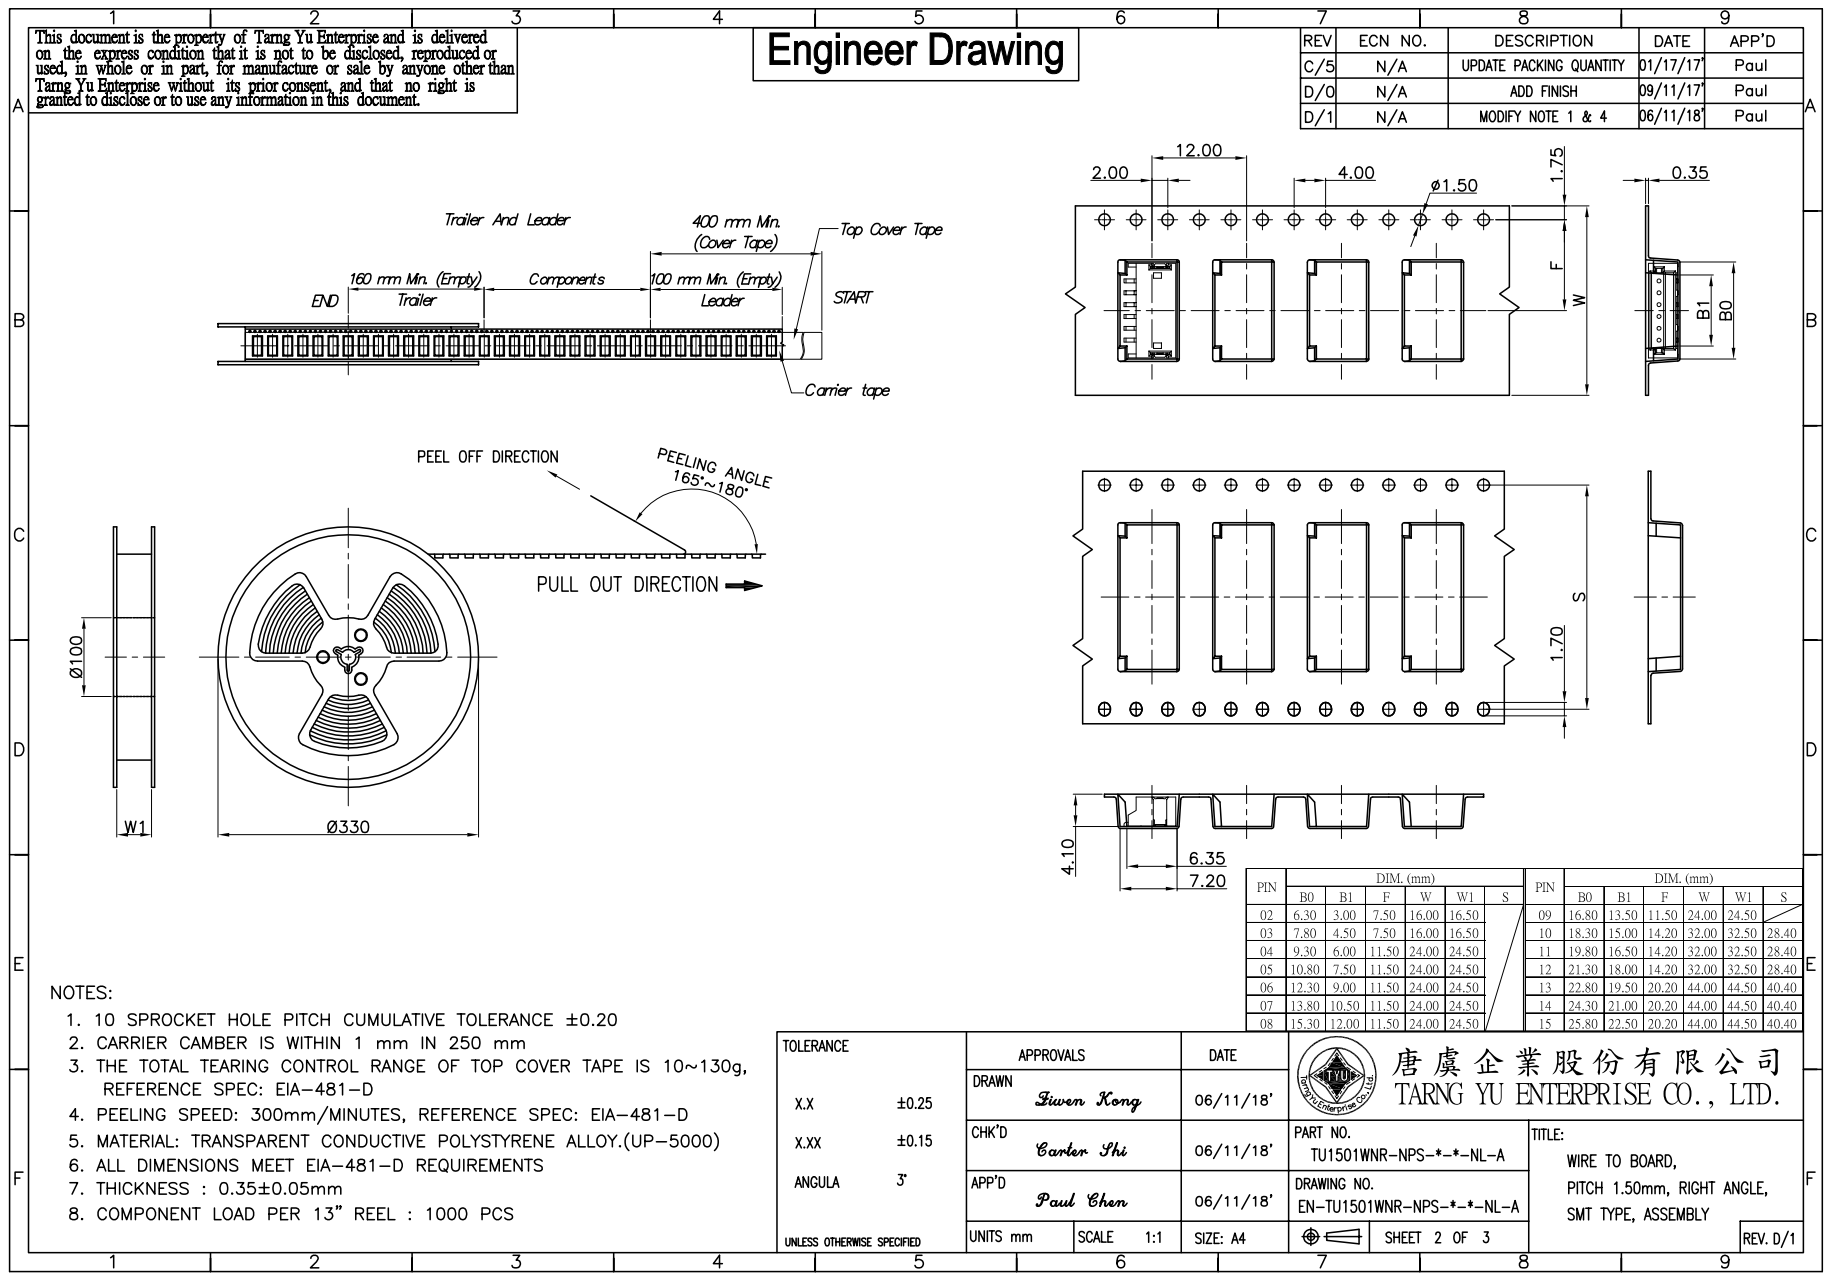
[picture p29: page 2]

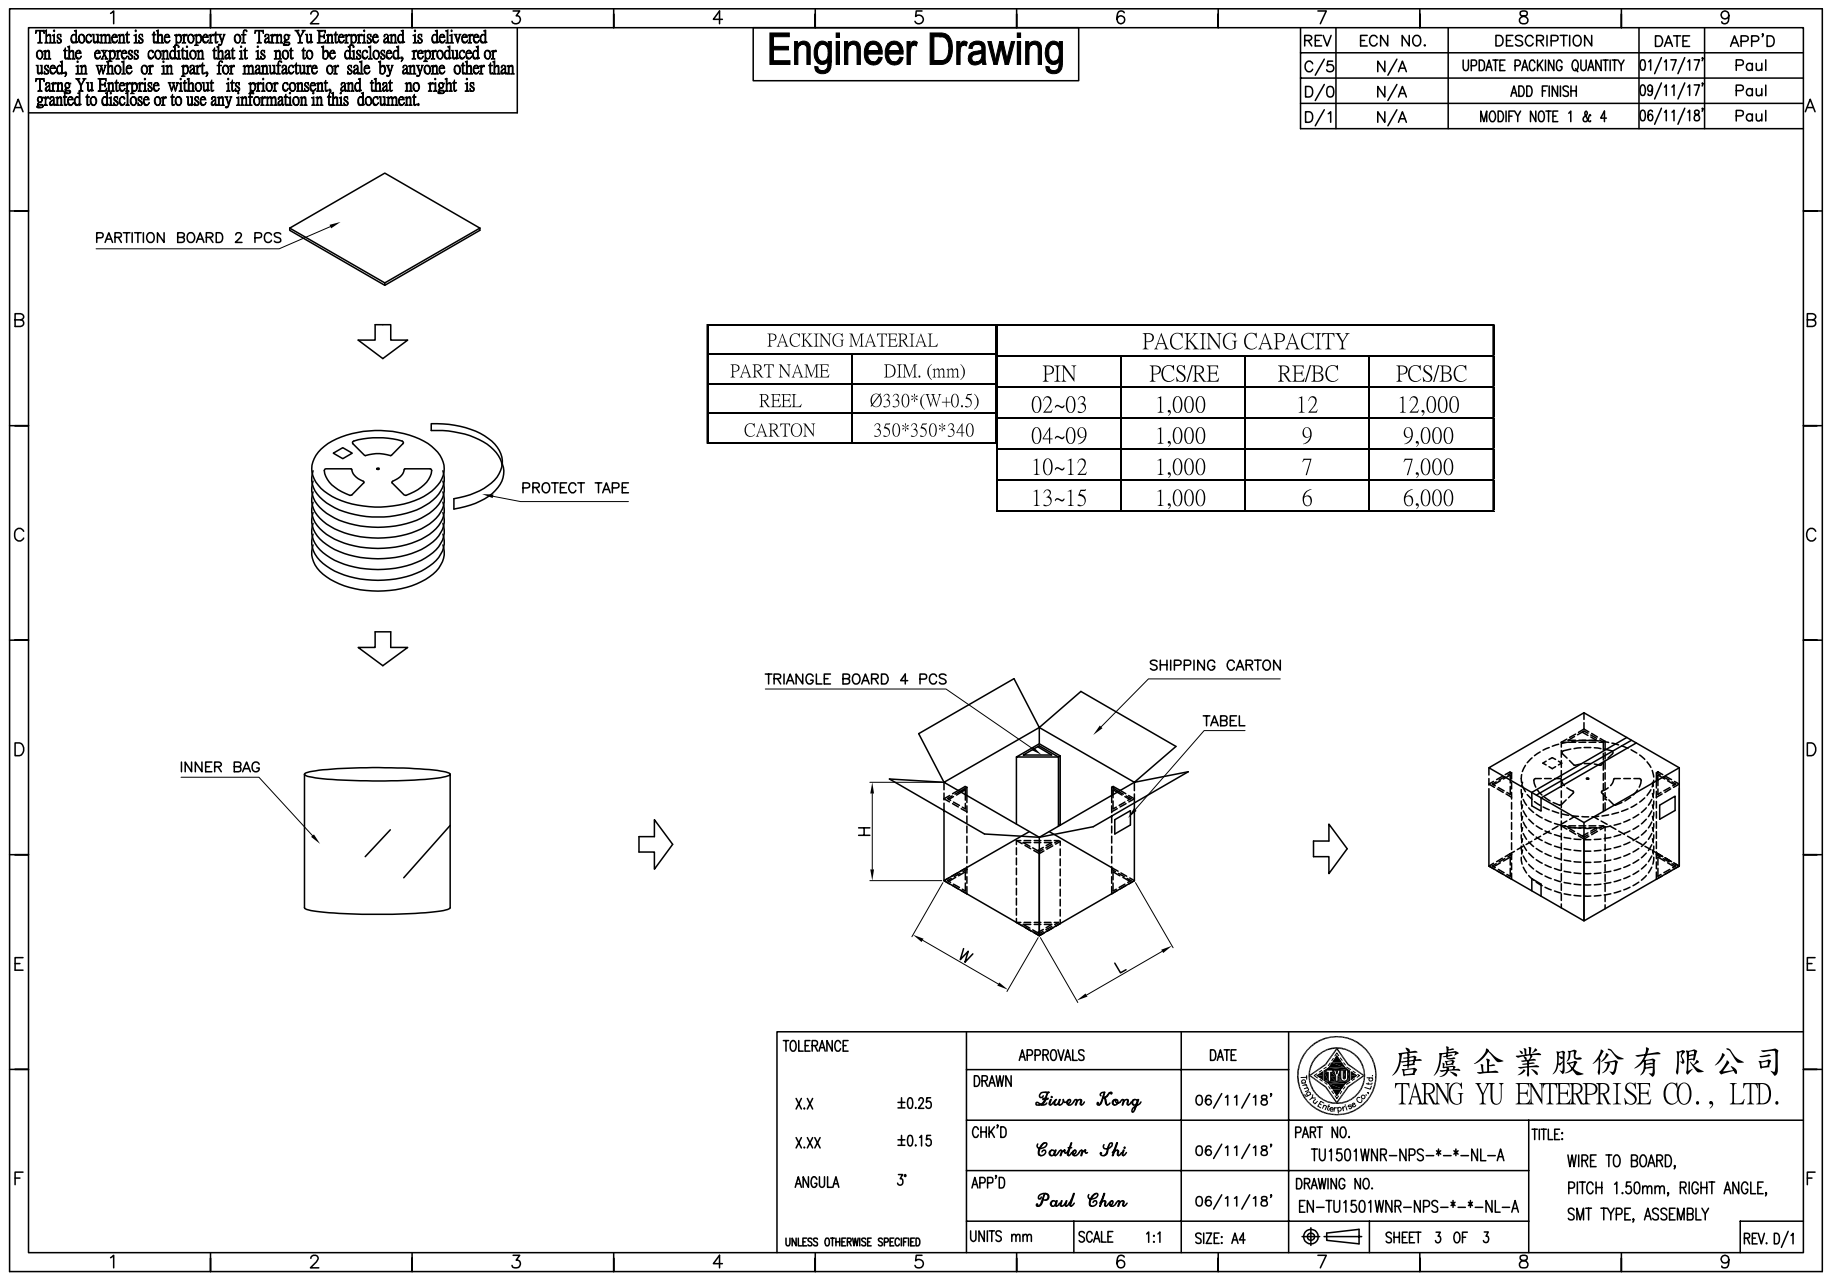
[picture p30: page 3]
