jianweizou/fun/doc/main_board_pcb_v1with 2CNTand 3pad.pdf

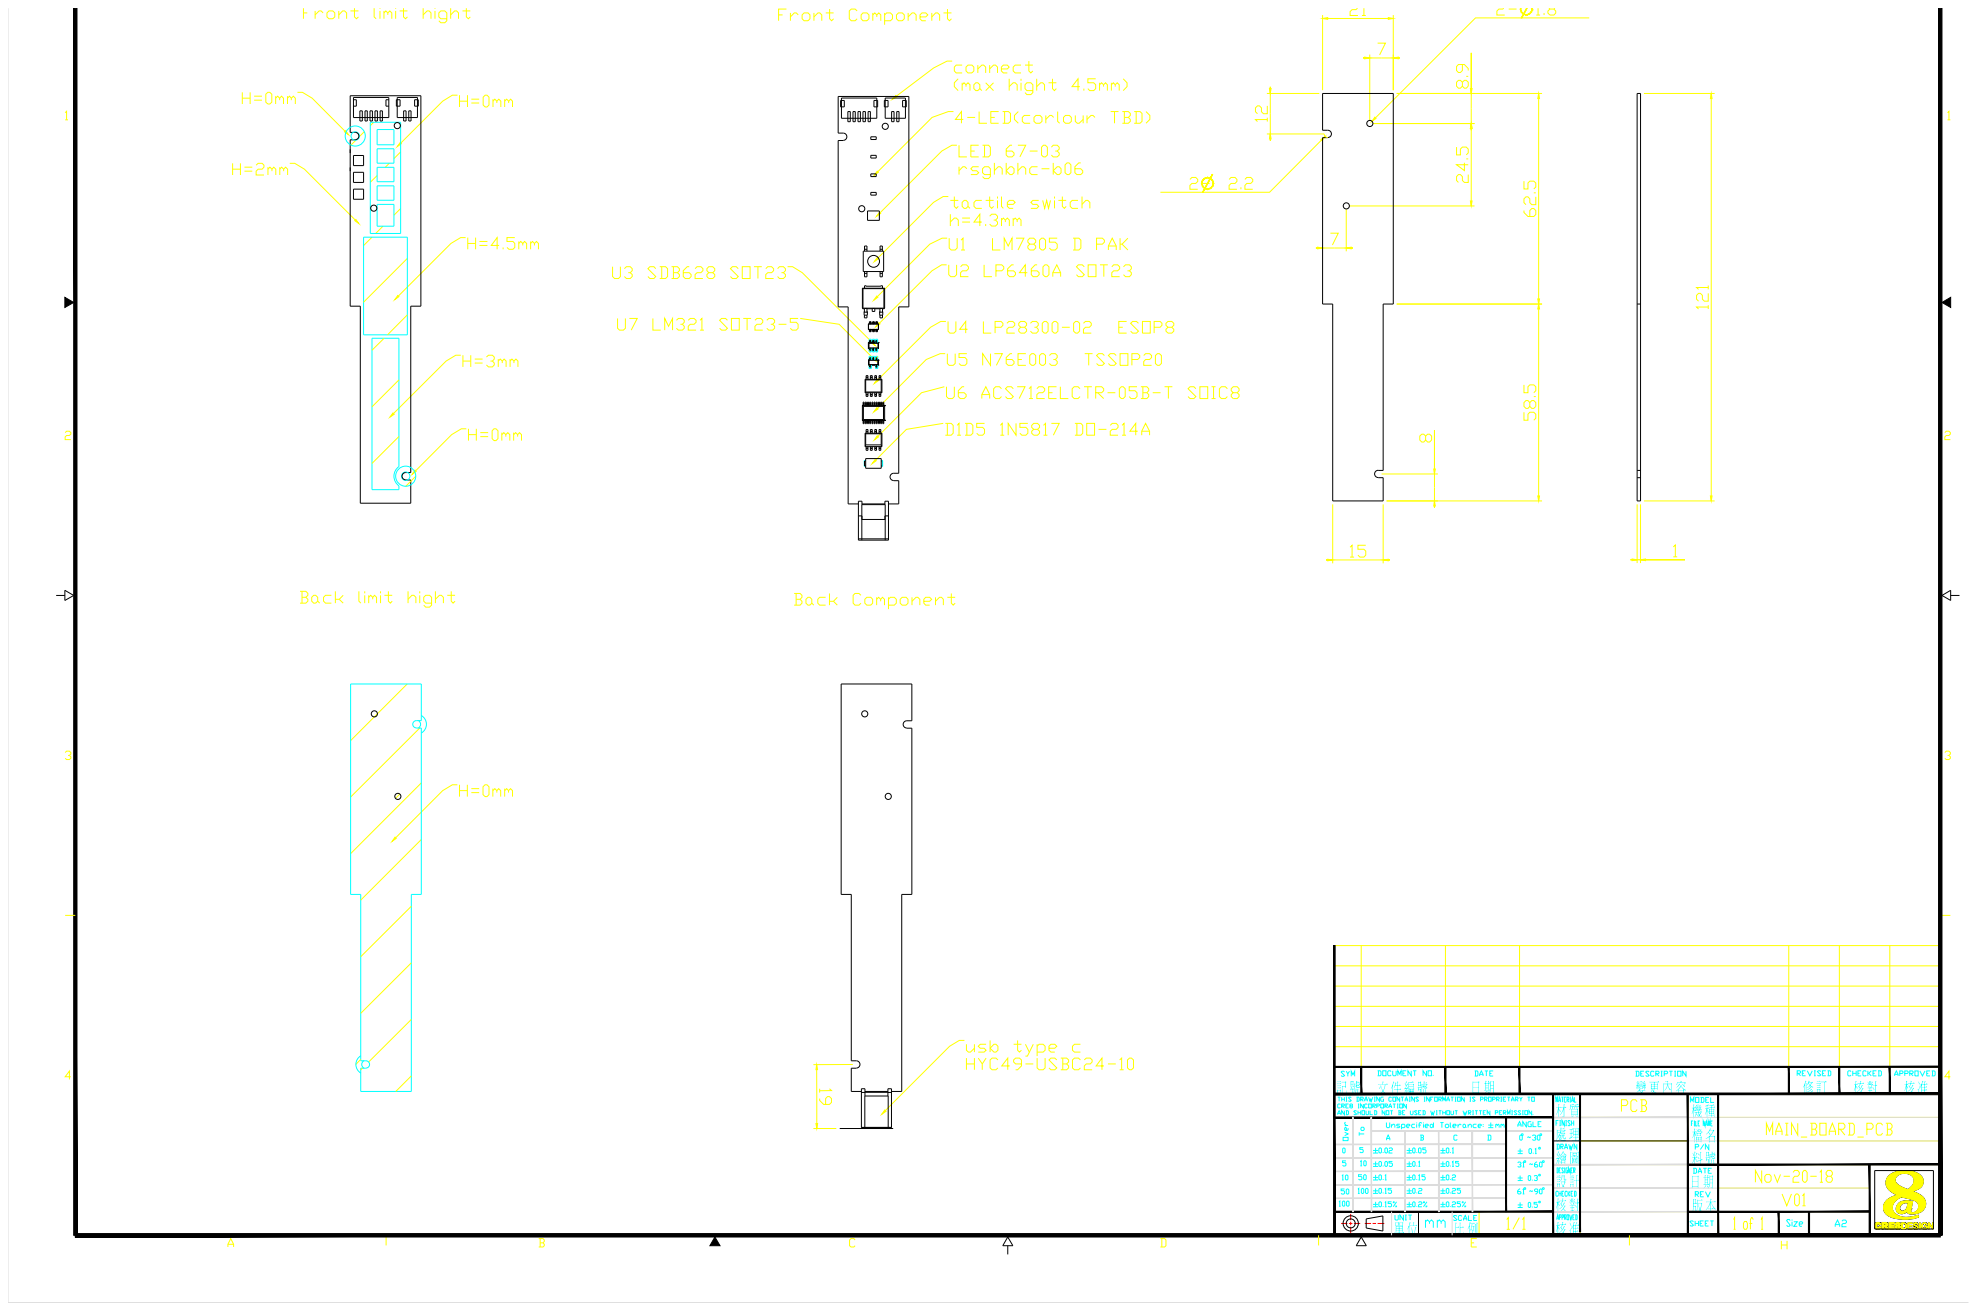
[picture p31: page 1]
