jianweizou/fun/(list of files, drawings)

Other design files:
layout/风扇_V1.4_20190213/风扇_V1.4.PcbDoc
layout/风扇_V1.4_20190213/风扇_V1.4.PrjPCB
layout/风扇_V1.4_20190213/风扇_V1.4.SchDoc
layout/风扇_V1.5_20190327/风扇_V1.5.PcbDoc
layout/风扇_V1.5_20190327/风扇_V1.5.PrjPCB
layout/风扇_V1.5_20190327/风扇_V1.5.SchDoc
layout/风扇_V1.6_20190413/风扇_V1.6.PcbDoc
layout/风扇_V1.6_20190413/风扇_V1.6.PrjPCB
layout/风扇_V1.6_20190413/风扇_V1.6.SchDoc
layout/风扇_V1.7_20190422/风扇_V1.7.PcbDoc
layout/风扇_V1.7_20190422/风扇_V1.7.PrjPCB
layout/风扇_V1.7_20190422/风扇_V1.7.SchDoc
layout/风扇_V1.8_20190429/风扇_V1.8.PcbDoc
layout/风扇_V1.8_20190429/风扇_V1.8.PrjPCB
layout/风扇_V1.8_20190429/风扇_V1.8.SchDoc
layout/风扇_V1.9_20190731/风扇_V1.9.PcbDoc
layout/风扇_V1.9_20190731/风扇_V1.9.PrjPCB
layout/风扇_V1.9_20190731/风扇_V1.9.SchDoc
