jianweizou/fun/code/sonix evb/3.SN7312_IIC_OLED/H/SNC7312.h

/****************************************************************************************************//**
 * @file     SNC7312.h
 *
 * @brief    CMSIS Cortex-M0 Core Peripheral Access Layer Header File for
 *           default SNC7312 Device Series
 *
 * @version  V1.0
 * @date     23. Feb 2016
 *
 * @par      ARM Limited (ARM) is supplying this software for use with Cortex-M
 *           processor based microcontroller, but can be equally used for other
 *           suitable processor architectures. This file can be freely distributed.
 *           Modifications to this file shall be clearly marked.
 *           
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
 *******************************************************************************************************/



/** @addtogroup SONiX Technology Co., Ltd.
  * @{
  */

/** @addtogroup SNC7312
  * @{
  */

#ifndef STC7312_H
#define STC7312_H

#ifdef __cplusplus
extern "C" {
#endif

#define SET_BIT0 	       0x00000001
#define SET_BIT1   	       0x00000002
#define SET_BIT2   	       0x00000004
#define SET_BIT3  	       0x00000008
#define SET_BIT4  	       0x00000010
#define SET_BIT5  	       0x00000020
#define SET_BIT6  	       0x00000040
#define SET_BIT7  	       0x00000080
#define SET_BIT8  	       0x00000100
#define SET_BIT9  	       0x00000200
#define SET_BIT10 	       0x00000400
#define SET_BIT11 	       0x00000800
#define SET_BIT12 	       0x00001000
#define SET_BIT13 	       0x00002000
#define SET_BIT14 	       0x00004000
#define SET_BIT15 	       0x00008000
#define SET_BIT16 	       0x00010000
#define SET_BIT17 	       0x00020000
#define SET_BIT18 	       0x00040000
#define SET_BIT19 	       0x00080000
#define SET_BIT20 	       0x00100000
#define SET_BIT21 	       0x00200000
#define SET_BIT22 	       0x00400000
#define SET_BIT23 	       0x00800000
#define SET_BIT24 	       0x01000000
#define SET_BIT25 	       0x02000000
#define SET_BIT26 	       0x04000000
#define SET_BIT27 	       0x08000000
#define SET_BIT28 	       0x10000000
#define SET_BIT29 	       0x20000000
#define SET_BIT30 	       0x40000000
#define SET_BIT31 	       0x80000000
	
	
/* -------------------------  Interrupt Number Definition  ------------------------------------------------------------------- */

typedef enum {
/* -------------------  Cortex-M0 Processor Exceptions Numbers  -------------------------------------------------------------- */
    Reset_IRQn                  = -15,              /*!<   1  Reset Vector, invoked on Power up and warm reset                 */
    NonMaskableInt_IRQn         = -14,              /*!<   2  Non maskable Interrupt, cannot be stopped or preempted           */
    HardFault_IRQn              = -13,              /*!<   3  Hard Fault, all classes of Fault                                 */
    SVCall_IRQn                 =  -5,              /*!<  11  System Service Call via SVC instruction                          */
    DebugMonitor_IRQn           =  -4,              /*!<  12  Debug Monitor                                                    */
    PendSV_IRQn                 =  -2,              /*!<  14  Pendable request for system service                              */
    SysTick_IRQn                =  -1,              /*!<  15  System Tick Timer                                                */
/* ---------------------  SNC7312 Specific Interrupt Numbers  ---------------------------------------------------------------- */
	MPU_IRQn					= 	0,				/*!<   0  MPU                                                              */
	DSP_Issue_IRQn				= 	1,				/*!<   1  DSP Issue                                                        */
	USBDEV_IRQn					=	2,				/*!<   2  USB Dec															*/
	CIS_IRQn					= 	3,				/*!<   3  CIS																*/
	PPU_HBLK_IRQn				= 	4,				/*!<   4  PPU_HBLK                                                         */
	SD_DAC_IRQn					=	5,				/*!<   5  SD DAC 			                                               */
	SD_ADC_IRQn					= 	6,				/*!<   6  SD ADC															*/
	DMA_SDNF1_IRQn				=	7,				/*!<   7  DMA SD_CARD1 | NF                                                */
	SPI1_IRQn					=	8,				/*!<   8  SPI1																*/
	I2S2_IRQn					=   9,				/*!<   9  I2S_2																*/
	DMA_CSC_IRQn				=  10,				/*!<  10  CSC_DMA															*/
	DMA_JPEG_IRQn				=  11,				/*!<  11  JPEG_DMA															*/
	CIS_VSYNC_IRQn				=  12,				/*!<  12  TFT																*/
	SPI0_IRQn                   =  13,              /*!<  13  SPI0                                                             */
	PPU_VBLK_IRQn               =  14,              /*!<  14  PPU_HBLK                                                         */
	I2C_IRQn                    =  15,              /*!<  15  I2C                                                              */
    CT16B0_IRQn                 =  16,              /*!<  16  CT16B0                                                           */
    CT16B1_IRQn                 =  17,              /*!<  17  CT16B1                                                           */
    CT32B0_IRQn                 =  18,              /*!<  18  CT32B0                                                           */
    CT32B1_IRQn                 =  19,              /*!<  19  CT32B1                                                           */
	P4_WKP_IRQn                 =  20,              /*!<  20  P4 | KEY_WKP                                                     */	
    UART0_IRQn                 	=  21,              /*!<  21  UART0                                                            */
	NFECC_IRQn					=  22,				/*!<  22  NFECC                                                            */
	DMA_SDNF0_IRQn				=  23,				/*!<  23  DMA SD_CARD0 | NF                                                */
	SAR_ADC_IRQn				=  24,				/*!<  24  SAR ADC                                                          */
	WDT_UART1_IRQn              =  25,              /*!<  25  WDT | UART1                                                      */
    USBHOST_IRQn                =  26,              /*!<  26  USB HOST                                                         */
    RTC_IRQn                    =  27,              /*!<  27  RTC | ISO_RTC                                                    */
	P3_IRQn                     =  28,              /*!<  28  P3                                                               */
    P2_IRQn                     =  29,              /*!<  29  P2                                                               */
	P1_IRQn                     =  30,              /*!<  30  P1                                                               */
	P0_IRQn                     =  31,              /*!<  31  P0                                                               */
	
} IRQn_Type;


/** @addtogroup Configuration_of_CMSIS
  * @{
  */


/* =========================================================================================================================== */
/* ====================================       Processor and Core Peripheral Section     ====================================== */
/* =========================================================================================================================== */

/* ------------------------------Configuration of the Cortex-M0 Processor and Core Peripherals-------------------------------- */
#define __CM0_REV                 0x0000            /*!< Cortex-M0 Core Revision                                               */
#define __MPU_PRESENT                  0            /*!< MPU present or not                                                    */
#define __NVIC_PRIO_BITS               2            /*!< Number of Bits used for Priority Levels                               */
#define __Vendor_SysTickConfig         0            /*!< Set to 1 if different SysTick Config is used                          */
/** @} */ /* End of group Configuration_of_CMSIS */

#include <core_cm0.h>                               /*!< Cortex-M0 processor and core peripherals                              */


typedef int32_t  s32;
typedef int16_t  s16;
typedef int8_t    s8;

typedef const int32_t sc32; 
typedef const int16_t sc16; 
typedef const int8_t   sc8;  

typedef __IO int32_t  vs32;
typedef __IO int16_t  vs16;
typedef __IO int8_t    vs8;

typedef __I int32_t  vsc32; 
typedef __I int16_t  vsc16; 
typedef __I int8_t    vsc8;  

typedef uint32_t       u32;
typedef uint16_t       u16;
typedef uint8_t         u8;

typedef const uint32_t uc32; 
typedef const uint16_t uc16; 
typedef const uint8_t   uc8;   

typedef __IO uint32_t  vu32;
typedef __IO uint16_t  vu16;
typedef __IO uint8_t    vu8;

typedef __I uint32_t vuc32; 
typedef __I uint16_t vuc16; 
typedef __I uint8_t   vuc8;  



/* =========================================================================================================================== */
/* ====================================       Device Specific Peripheral Section       ======================================= */
/* =========================================================================================================================== */

/** @addtogroup Device_Peripheral_Registers
  * @{
  */


/* -------------------  Start of section using anonymous unions  ------------------ */
#if defined(__CC_ARM)
  #pragma push
  #pragma anon_unions
#elif defined(__ICCARM__)
  #pragma language=extended
#elif defined(__GNUC__)
  /* anonymous unions are enabled by default */
#elif defined(__TMS470__)
/* anonymous unions are enabled by default */
#elif defined(__TASKING__)
  #pragma warning 586
#else
  #warning Not supported compiler type
#endif


/* =========================================================================================================================== */
/* ====================================                    SN_GPIO0                    ======================================= */
/* =========================================================================================================================== */
/**
  * @brief General Purpose I/O (SN_GPIO0)
  */

typedef struct {                                    /*!< SN_GPIO0 Structure                                                    */
  
  union {
    __IO uint32_t  DATA;                            /*!< Offset:0x00 GPIO Port n Data Register                                 */
    
    struct {
      __IO uint32_t  DATA0      :  1;               /*!< Data of Pn.0                                                          */
      __IO uint32_t  DATA1      :  1;               /*!< Data of Pn.1                                                          */
      __IO uint32_t  DATA2      :  1;               /*!< Data of Pn.2                                                          */
      __IO uint32_t  DATA3      :  1;               /*!< Data of Pn.3                                                          */
      __IO uint32_t  DATA4      :  1;               /*!< Data of Pn.4                                                          */
      __IO uint32_t  DATA5      :  1;               /*!< Data of Pn.5                                                          */
      __IO uint32_t  DATA6      :  1;               /*!< Data of Pn.6                                                          */
      __IO uint32_t  DATA7      :  1;               /*!< Data of Pn.7                                                          */
      __IO uint32_t  DATA8      :  1;               /*!< Data of Pn.8                                                          */
      __IO uint32_t  DATA9      :  1;               /*!< Data of Pn.9                                                          */
      __IO uint32_t  DATA10     :  1;               /*!< Data of Pn.10                                                         */
      __IO uint32_t  DATA11     :  1;               /*!< Data of Pn.11                                                         */
      __IO uint32_t  DATA12     :  1;               /*!< Data of Pn.12                                                         */
      __IO uint32_t  DATA13     :  1;               /*!< Data of Pn.13                                                         */
      __IO uint32_t  DATA14     :  1;               /*!< Data of Pn.14                                                         */
      __IO uint32_t  DATA15     :  1;               /*!< Data of Pn.15                                                         */
    } DATA_b;                                       /*!< BitSize                                                               */
  };
  
  union {
    __IO uint32_t  MODE;                            /*!< Offset:0x04 GPIO Port n Mode Register                                 */
    
    struct {
      __IO uint32_t  MODE0      :  1;               /*!< Mode of Pn.0                                                          */
      __IO uint32_t  MODE1      :  1;               /*!< Mode of Pn.1                                                          */
      __IO uint32_t  MODE2      :  1;               /*!< Mode of Pn.2                                                          */
      __IO uint32_t  MODE3      :  1;               /*!< Mode of Pn.3                                                          */
      __IO uint32_t  MODE4      :  1;               /*!< Mode of Pn.4                                                          */
      __IO uint32_t  MODE5      :  1;               /*!< Mode of Pn.5                                                          */
      __IO uint32_t  MODE6      :  1;               /*!< Mode of Pn.6                                                          */
      __IO uint32_t  MODE7      :  1;               /*!< Mode of Pn.7                                                          */
      __IO uint32_t  MODE8      :  1;               /*!< Mode of Pn.8                                                          */
      __IO uint32_t  MODE9      :  1;               /*!< Mode of Pn.9                                                          */
      __IO uint32_t  MODE10     :  1;               /*!< Mode of Pn.10                                                         */
      __IO uint32_t  MODE11     :  1;               /*!< Mode of Pn.11                                                         */
      __IO uint32_t  MODE12     :  1;               /*!< Mode of Pn.12                                                         */
      __IO uint32_t  MODE13     :  1;               /*!< Mode of Pn.13                                                         */
      __IO uint32_t  MODE14     :  1;               /*!< Mode of Pn.14                                                         */
      __IO uint32_t  MODE15     :  1;               /*!< Mode of Pn.15                                                         */
    } MODE_b;                                       /*!< BitSize                                                               */
  };
  
  union {
    __IO uint32_t  CFG;                             /*!< Offset:0x08 GPIO Port n Configuration Register                        */
    
    struct {
      __IO uint32_t  CFG0       :  2;               /*!< Configuration of Pn.0                                                 */
      __IO uint32_t  CFG1       :  2;               /*!< Configuration of Pn.1                                                 */
      __IO uint32_t  CFG2       :  2;               /*!< Configuration of Pn.2                                                 */
      __IO uint32_t  CFG3       :  2;               /*!< Configuration of Pn.3                                                 */
      __IO uint32_t  CFG4       :  2;               /*!< Configuration of Pn.4                                                 */
      __IO uint32_t  CFG5       :  2;               /*!< Configuration of Pn.5                                                 */
      __IO uint32_t  CFG6       :  2;               /*!< Configuration of Pn.6                                                 */
      __IO uint32_t  CFG7       :  2;               /*!< Configuration of Pn.7                                                 */
      __IO uint32_t  CFG8       :  2;               /*!< Configuration of Pn.8                                                 */
      __IO uint32_t  CFG9       :  2;               /*!< Configuration of Pn.9                                                 */
      __IO uint32_t  CFG10      :  2;               /*!< Configuration of Pn.10                                                */
      __IO uint32_t  CFG11      :  2;               /*!< Configuration of Pn.11                                                */
      __IO uint32_t  CFG12      :  2;               /*!< Configuration of Pn.12                                                */
      __IO uint32_t  CFG13      :  2;               /*!< Configuration of Pn.13                                                */
      __IO uint32_t  CFG14      :  2;               /*!< Configuration of Pn.14                                                */
      __IO uint32_t  CFG15      :  2;               /*!< Configuration of Pn.15                                                */
    } CFG_b;                                        /*!< BitSize                                                               */
  };
  
  union {
    __IO uint32_t  IS;                              /*!< Offset:0x0C GPIO Port n Interrupt Sense Register                      */
    
    struct {
      __IO uint32_t  IS0        :  1;               /*!< Interrupt on Pn.0 is event or edge sensitive                          */
      __IO uint32_t  IS1        :  1;               /*!< Interrupt on Pn.1 is event or edge sensitive                          */
      __IO uint32_t  IS2        :  1;               /*!< Interrupt on Pn.2 is event or edge sensitive                          */
      __IO uint32_t  IS3        :  1;               /*!< Interrupt on Pn.3 is event or edge sensitive                          */
      __IO uint32_t  IS4        :  1;               /*!< Interrupt on Pn.4 is event or edge sensitive                          */
      __IO uint32_t  IS5        :  1;               /*!< Interrupt on Pn.5 is event or edge sensitive                          */
      __IO uint32_t  IS6        :  1;               /*!< Interrupt on Pn.6 is event or edge sensitive                          */
      __IO uint32_t  IS7        :  1;               /*!< Interrupt on Pn.7 is event or edge sensitive                          */
      __IO uint32_t  IS8        :  1;               /*!< Interrupt on Pn.8 is event or edge sensitive                          */
      __IO uint32_t  IS9        :  1;               /*!< Interrupt on Pn.9 is event or edge sensitive                          */
      __IO uint32_t  IS10       :  1;               /*!< Interrupt on Pn.10 is event or edge sensitive                         */
      __IO uint32_t  IS11       :  1;               /*!< Interrupt on Pn.11 is event or edge sensitive                         */
      __IO uint32_t  IS12       :  1;               /*!< Interrupt on Pn.12 is event or edge sensitive                         */
      __IO uint32_t  IS13       :  1;               /*!< Interrupt on Pn.13 is event or edge sensitive                         */
      __IO uint32_t  IS14       :  1;               /*!< Interrupt on Pn.14 is event or edge sensitive                         */
      __IO uint32_t  IS15       :  1;               /*!< Interrupt on Pn.15 is event or edge sensitive                         */
    } IS_b;                                         /*!< BitSize                                                               */
  };
  
  union {
    __IO uint32_t  IBS;                             /*!< Offset:0x10 GPIO Port n Interrupt Both-edge Sense Register            */
    
    struct {
      __IO uint32_t  IBS0       :  1;               /*!< Interrupt on Pn.0 is triggered ob both edges                          */
      __IO uint32_t  IBS1       :  1;               /*!< Interrupt on Pn.1 is triggered ob both edges                          */
      __IO uint32_t  IBS2       :  1;               /*!< Interrupt on Pn.2 is triggered ob both edges                          */
      __IO uint32_t  IBS3       :  1;               /*!< Interrupt on Pn.3 is triggered ob both edges                          */
      __IO uint32_t  IBS4       :  1;               /*!< Interrupt on Pn.4 is triggered ob both edges                          */
      __IO uint32_t  IBS5       :  1;               /*!< Interrupt on Pn.5 is triggered ob both edges                          */
      __IO uint32_t  IBS6       :  1;               /*!< Interrupt on Pn.6 is triggered ob both edges                          */
      __IO uint32_t  IBS7       :  1;               /*!< Interrupt on Pn.7 is triggered ob both edges                          */
      __IO uint32_t  IBS8       :  1;               /*!< Interrupt on Pn.8 is triggered ob both edges                          */
      __IO uint32_t  IBS9       :  1;               /*!< Interrupt on Pn.9 is triggered ob both edges                          */
      __IO uint32_t  IBS10      :  1;               /*!< Interrupt on Pn.10 is triggered ob both edges                         */
      __IO uint32_t  IBS11      :  1;               /*!< Interrupt on Pn.11 is triggered ob both edges                         */
      __IO uint32_t  IBS12      :  1;               /*!< Interrupt on Pn.12 is triggered ob both edges                         */
      __IO uint32_t  IBS13      :  1;               /*!< Interrupt on Pn.13 is triggered ob both edges                         */
      __IO uint32_t  IBS14      :  1;               /*!< Interrupt on Pn.14 is triggered ob both edges                         */
      __IO uint32_t  IBS15      :  1;               /*!< Interrupt on Pn.15 is triggered ob both edges                         */
    } IBS_b;                                        /*!< BitSize                                                               */
  };
  
  union {
    __IO uint32_t  IEV;                             /*!< Offset:0x14 GPIO Port n Interrupt Event Register                      */
    
    struct {
      __IO uint32_t  IEV0       :  1;               /*!< Interrupt trigged evnet on Pn.0                                       */
      __IO uint32_t  IEV1       :  1;               /*!< Interrupt trigged evnet on Pn.1                                       */
      __IO uint32_t  IEV2       :  1;               /*!< Interrupt trigged evnet on Pn.2                                       */
      __IO uint32_t  IEV3       :  1;               /*!< Interrupt trigged evnet on Pn.3                                       */
      __IO uint32_t  IEV4       :  1;               /*!< Interrupt trigged evnet on Pn.4                                       */
      __IO uint32_t  IEV5       :  1;               /*!< Interrupt trigged evnet on Pn.5                                       */
      __IO uint32_t  IEV6       :  1;               /*!< Interrupt trigged evnet on Pn.6                                       */
      __IO uint32_t  IEV7       :  1;               /*!< Interrupt trigged evnet on Pn.7                                       */
      __IO uint32_t  IEV8       :  1;               /*!< Interrupt trigged evnet on Pn.8                                       */
      __IO uint32_t  IEV9       :  1;               /*!< Interrupt trigged evnet on Pn.9                                       */
      __IO uint32_t  IEV10      :  1;               /*!< Interrupt trigged evnet on Pn.10                                      */
      __IO uint32_t  IEV11      :  1;               /*!< Interrupt trigged evnet on Pn.11                                      */
      __IO uint32_t  IEV12      :  1;               /*!< Interrupt trigged evnet on Pn.12                                      */
      __IO uint32_t  IEV13      :  1;               /*!< Interrupt trigged evnet on Pn.13                                      */
      __IO uint32_t  IEV14      :  1;               /*!< Interrupt trigged evnet on Pn.14                                      */
      __IO uint32_t  IEV15      :  1;               /*!< Interrupt trigged evnet on Pn.15                                      */
    } IEV_b;                                        /*!< BitSize                                                               */
  };
  
  union {
    __IO uint32_t  IE;                              /*!< Offset:0x18 GPIO Port n Interrupt Enable Register                     */
    
    struct {
      __IO uint32_t  IE0        :  1;               /*!< Interrupt on Pn.0 enable                                              */
      __IO uint32_t  IE1        :  1;               /*!< Interrupt on Pn.1 enable                                              */
      __IO uint32_t  IE2        :  1;               /*!< Interrupt on Pn.2 enable                                              */
      __IO uint32_t  IE3        :  1;               /*!< Interrupt on Pn.3 enable                                              */
      __IO uint32_t  IE4        :  1;               /*!< Interrupt on Pn.4 enable                                              */
      __IO uint32_t  IE5        :  1;               /*!< Interrupt on Pn.5 enable                                              */
      __IO uint32_t  IE6        :  1;               /*!< Interrupt on Pn.6 enable                                              */
      __IO uint32_t  IE7        :  1;               /*!< Interrupt on Pn.7 enable                                              */
      __IO uint32_t  IE8        :  1;               /*!< Interrupt on Pn.8 enable                                              */
      __IO uint32_t  IE9        :  1;               /*!< Interrupt on Pn.9 enable                                              */
      __IO uint32_t  IE10       :  1;               /*!< Interrupt on Pn.10 enable                                             */
      __IO uint32_t  IE11       :  1;               /*!< Interrupt on Pn.11 enable                                             */
      __IO uint32_t  IE12       :  1;               /*!< Interrupt on Pn.11 enable                                             */
      __IO uint32_t  IE13       :  1;               /*!< Interrupt on Pn.13 enable                                             */
      __IO uint32_t  IE14       :  1;               /*!< Interrupt on Pn.14 enable                                             */
      __IO uint32_t  IE15       :  1;               /*!< Interrupt on Pn.15 enable                                             */
    } IE_b;                                         /*!< BitSize                                                               */
  };
  
  union {
    __I  uint32_t  RIS;                             /*!< Offset:0x1C GPIO Port n Raw Interrupt Status Register                 */
    
    struct {
      __I  uint32_t  IF0        :  1;               /*!< Pn.0 raw interrupt flag                                               */
      __I  uint32_t  IF1        :  1;               /*!< Pn.1 raw interrupt flag                                               */
      __I  uint32_t  IF2        :  1;               /*!< Pn.2 raw interrupt flag                                               */
      __I  uint32_t  IF3        :  1;               /*!< Pn.3 raw interrupt flag                                               */
      __I  uint32_t  IF4        :  1;               /*!< Pn.4 raw interrupt flag                                               */
      __I  uint32_t  IF5        :  1;               /*!< Pn.5 raw interrupt flag                                               */
      __I  uint32_t  IF6        :  1;               /*!< Pn.6 raw interrupt flag                                               */
      __I  uint32_t  IF7        :  1;               /*!< Pn.7 raw interrupt flag                                               */
      __I  uint32_t  IF8        :  1;               /*!< Pn.8 raw interrupt flag                                               */
      __I  uint32_t  IF9        :  1;               /*!< Pn.9 raw interrupt flag                                               */
      __I  uint32_t  IF10       :  1;               /*!< Pn.10 raw interrupt flag                                              */
      __I  uint32_t  IF11       :  1;               /*!< Pn.11 raw interrupt flag                                              */
      __I  uint32_t  IF12       :  1;               /*!< Pn.12 raw interrupt flag                                              */
      __I  uint32_t  IF13       :  1;               /*!< Pn.13 raw interrupt flag                                              */
      __I  uint32_t  IF14       :  1;               /*!< Pn.14 raw interrupt flag                                              */
      __I  uint32_t  IF15       :  1;               /*!< Pn.15 raw interrupt flag                                              */
    } RIS_b;                                        /*!< BitSize                                                               */
  };
  
  union {
    __O  uint32_t  IC;                              /*!< Offset:0x20 GPIO Port n Interrupt Clear Register                      */
    
    struct {
      __O  uint32_t  IC0        :  1;               /*!< Pn.0 interrupt flag clear                                             */
      __O  uint32_t  IC1        :  1;               /*!< Pn.1 interrupt flag clear                                             */
      __O  uint32_t  IC2        :  1;               /*!< Pn.2 interrupt flag clear                                             */
      __O  uint32_t  IC3        :  1;               /*!< Pn.3 interrupt flag clear                                             */
      __O  uint32_t  IC4        :  1;               /*!< Pn.4 interrupt flag clear                                             */
      __O  uint32_t  IC5        :  1;               /*!< Pn.5 interrupt flag clear                                             */
      __O  uint32_t  IC6        :  1;               /*!< Pn.6 interrupt flag clear                                             */
      __O  uint32_t  IC7        :  1;               /*!< Pn.7 interrupt flag clear                                             */
      __O  uint32_t  IC8        :  1;               /*!< Pn.8 interrupt flag clear                                             */
      __O  uint32_t  IC9        :  1;               /*!< Pn.9 interrupt flag clear                                             */
      __O  uint32_t  IC10       :  1;               /*!< Pn.10 interrupt flag clear                                            */
      __O  uint32_t  IC11       :  1;               /*!< Pn.11 interrupt flag clear                                            */
      __O  uint32_t  IC12       :  1;               /*!< Pn.12 interrupt flag clear                                            */
      __O  uint32_t  IC13       :  1;               /*!< Pn.13 interrupt flag clear                                            */
      __O  uint32_t  IC14       :  1;               /*!< Pn.14 interrupt flag clear                                            */
      __O  uint32_t  IC15       :  1;               /*!< Pn.15 interrupt flag clear                                            */
    } IC_b;                                         /*!< BitSize                                                               */
  };
  
  union {
    __O  uint32_t  BSET;                            /*!< Offset:0x24 GPIO Port n Bits Set Operation Register                   */
    
    struct {
      __O  uint32_t  BSET0      :  1;               /*!< Set Pn.0                                                              */
      __O  uint32_t  BSET1      :  1;               /*!< Set Pn.1                                                              */
      __O  uint32_t  BSET2      :  1;               /*!< Set Pn.2                                                              */
      __O  uint32_t  BSET3      :  1;               /*!< Set Pn.3                                                              */
      __O  uint32_t  BSET4      :  1;               /*!< Set Pn.4                                                              */
      __O  uint32_t  BSET5      :  1;               /*!< Set Pn.5                                                              */
      __O  uint32_t  BSET6      :  1;               /*!< Set Pn.6                                                              */
      __O  uint32_t  BSET7      :  1;               /*!< Set Pn.7                                                              */
      __O  uint32_t  BSET8      :  1;               /*!< Set Pn.8                                                              */
      __O  uint32_t  BSET9      :  1;               /*!< Set Pn.9                                                              */
      __O  uint32_t  BSET10     :  1;               /*!< Set Pn.10                                                             */
      __O  uint32_t  BSET11     :  1;               /*!< Set Pn.11                                                             */
      __O  uint32_t  BSET12     :  1;               /*!< Set Pn.12                                                             */
      __O  uint32_t  BSET13     :  1;               /*!< Set Pn.13                                                             */
      __O  uint32_t  BSET14     :  1;               /*!< Set Pn.14                                                             */
      __O  uint32_t  BSET15     :  1;               /*!< Set Pn.15                                                             */
    } BSET_b;                                       /*!< BitSize                                                               */
  };
  
  union {
    __O  uint32_t  BCLR;                            /*!< Offset:0x28 GPIO Port n Bits Clear Operation Register                 */
    
    struct {
      __O  uint32_t  BCLR0      :  1;               /*!< Clear Pn.0                                                            */
      __O  uint32_t  BCLR1      :  1;               /*!< Clear Pn.1                                                            */
      __O  uint32_t  BCLR2      :  1;               /*!< Clear Pn.2                                                            */
      __O  uint32_t  BCLR3      :  1;               /*!< Clear Pn.3                                                            */
      __O  uint32_t  BCLR4      :  1;               /*!< Clear Pn.4                                                            */
      __O  uint32_t  BCLR5      :  1;               /*!< Clear Pn.5                                                            */
      __O  uint32_t  BCLR6      :  1;               /*!< Clear Pn.6                                                            */
      __O  uint32_t  BCLR7      :  1;               /*!< Clear Pn.7                                                            */
      __O  uint32_t  BCLR8      :  1;               /*!< Clear Pn.8                                                            */
      __O  uint32_t  BCLR9      :  1;               /*!< Clear Pn.9                                                            */
      __O  uint32_t  BCLR10     :  1;               /*!< Clear Pn.10                                                           */
      __O  uint32_t  BCLR11     :  1;               /*!< Clear Pn.11                                                           */
      __O  uint32_t  BCLR12     :  1;               /*!< Clear Pn.12                                                           */
      __O  uint32_t  BCLR13     :  1;               /*!< Clear Pn.13                                                           */
      __O  uint32_t  BCLR14     :  1;               /*!< Clear Pn.14                                                           */
      __O  uint32_t  BCLR15     :  1;               /*!< Clear Pn.15                                                           */
    } BCLR_b;                                       /*!< BitSize                                                               */
  };
  
  union {
    __IO uint32_t  ODCTRL;                          /*!< Offset:0x2C GPIO Port n Open-drain Control Register                   */
    
    struct {
      __IO uint32_t  Pn0OC      :  1;               /*!< Pn.0 open-drain control                                               */
      __IO uint32_t  Pn1OC      :  1;               /*!< Pn.1 open-drain control                                               */
      __IO uint32_t  Pn2OC      :  1;               /*!< Pn.2 open-drain control                                               */
      __IO uint32_t  Pn3OC      :  1;               /*!< Pn.3 open-drain control                                               */
           uint32_t             :  8;
      __IO uint32_t  Pn12OC     :  1;               /*!< Pn.12 open-drain control                                              */
      __IO uint32_t  Pn13OC     :  1;               /*!< Pn.13 open-drain control                                              */
      __IO uint32_t  Pn14OC     :  1;               /*!< Pn.14 open-drain control                                              */
      __IO uint32_t  Pn15OC     :  1;               /*!< Pn.15 open-drain control                                              */
    } ODCTRL_b;                                     /*!< BitSize                                                               */
  };
} SN_GPIO0_Type;


/* =========================================================================================================================== */
/* ====================================                    SN_WDT                      ======================================= */
/* =========================================================================================================================== */
/**
  * @brief Watchdog Timer (SN_WDT)
  */

typedef struct {                                    /*!< SN_WDT Structure                                                      */
  
  union {
    __IO uint32_t  CFG;                             /*!< Offset:0x00 WDT Configuration Register                                */
    
    struct {
      __IO uint32_t  WDTEN      :  1;               /*!< WDT enable                                                            */
      __IO uint32_t  WDTIE      :  1;               /*!< WDT interrupt enable                                                  */
      __IO uint32_t  WDTINT     :  1;               /*!< WDT interrupt flag                                                    */
           uint32_t             : 13;
      __O  uint32_t  WDKEY      : 16;               /*!< Watchdog register key                                                 */
    } CFG_b;                                        /*!< BitSize                                                               */
  };
  
  union {
    __IO uint32_t  CLKSOURCE;                       /*!< Offset:0x04 WDT Clock Source Register                                 */
    
    struct {
      __IO uint32_t  CLKSOURCE  :  2;               /*!< WDT clock source                                                      */
           uint32_t             : 14;
      __O  uint32_t  WDKEY      : 16;               /*!< Watchdog register key                                                 */
    } CLKSOURCE_b;                                  /*!< BitSize                                                               */
  };
  
  union {
    __IO uint32_t  TC;                              /*!< Offset:0x08 WDT Timer Constant Register                               */
    
    struct {
      __IO uint32_t  TC         :  8;               /*!< Watchdog timer constant reload value                                  */
           uint32_t             :  8;
      __O  uint32_t  WDKEY      : 16;               /*!< Watchdog register key                                                 */
    } TC_b;                                         /*!< BitSize                                                               */
  };
  
  union {
    __O  uint32_t  FEED;                            /*!< Offset:0x0C WDT Feed Register                                         */
    
    struct {
      __O  uint32_t  FV         : 16;               /*!< Watchdog feed value                                                   */
      __O  uint32_t  WDKEY      : 16;               /*!< Watchdog register key                                                 */
    } FEED_b;                                       /*!< BitSize                                                               */
  };
} SN_WDT_Type;


/* =========================================================================================================================== */
/* ====================================                    SN_RTC                      ======================================= */
/* =========================================================================================================================== */
/**
  * @brief Real-time Clock (SN_RTC)
  */

typedef struct {                                    /*!< SN_RTC Structure                                                      */
  
  union {
    __IO uint32_t  CTRL;                            /*!< Offset:0x00 RTC Control Register                                      */
    
    struct {
      __IO uint32_t  RTCEN      :  1;               /*!< RTC enable                                                            */
    } CTRL_b;                                       /*!< BitSize                                                               */
  };
  
  union {
    __IO uint32_t  CLKS;                            /*!< Offset:0x04 RTC Clock Source Register                                 */
    
    struct {
      __IO uint32_t  CLKSEL     :  2;               /*!< RTC clock source                                                      */
    } CLKS_b;                                       /*!< BitSize                                                               */
  };
  
  union {
    __IO uint32_t  IE;                              /*!< Offset:0x08 RTC Interrupt Enable Register                             */
    
    struct {
      __IO uint32_t  SECIE      :  1;               /*!< Second interrupt enable                                               */
      __IO uint32_t  ALMIE      :  1;               /*!< Alarm interrupt enable                                                */
      __IO uint32_t  OVFIE      :  1;               /*!< Overflow interrupt enable                                             */
    } IE_b;                                         /*!< BitSize                                                               */
  };
  
  union {
    __I  uint32_t  RIS;                             /*!< Offset:0x0C RTC Raw Interrupt Status Register                         */
    
    struct {
      __I  uint32_t  SECIF      :  1;               /*!< Second interrupt flag                                                 */
      __I  uint32_t  ALMIF      :  1;               /*!< Alarm interrupt flag                                                  */
      __I  uint32_t  OVFIF      :  1;               /*!< Overflow interrupt flag                                               */
    } RIS_b;                                        /*!< BitSize                                                               */
  };
  
  union {
    __O  uint32_t  IC;                              /*!< Offset:0x10 RTC Interrupt Clear Register                              */
    
    struct {
      __O  uint32_t  SECIC      :  1;               /*!< Second interrupt flag clear                                           */
      __O  uint32_t  ALMIC      :  1;               /*!< Alarm interrupt flag clear                                            */
      __O  uint32_t  OVFIC      :  1;               /*!< Overflow interrupt flag clear                                         */
    } IC_b;                                         /*!< BitSize                                                               */
  };
  __IO uint32_t  SECCNTV;                           /*!< Offset:0x14 RTC Second Counter Reload Value Register                  */
  __I  uint32_t  SECCNT;                            /*!< Offset:0x18 RTC Second Counter Register                               */
  __IO uint32_t  ALMCNTV;                           /*!< Offset:0x1C RTC Alarm Counter Reload Value Register                   */
  __I  uint32_t  ALMCNT;                            /*!< Offset:0x20 RTC Alarm Counter Register                                */
} SN_RTC_Type;


/* =========================================================================================================================== */
/* ====================================                    SN_CT16B0                   ======================================= */
/* =========================================================================================================================== */
/**
  * @brief 16-bit Timer 0 with Capture function (SN_CT16B0)
  */

typedef struct {                                    /*!< SN_CT16B0 Structure                                                   */
  
  union {
    __IO uint32_t  TMRCTRL;                         /*!< Offset:0x00 CT16Bn Timer Control Register                             */
    
    struct {
      __IO uint32_t  CEN        :  1;               /*!< Counter enable                                                        */
      __IO uint32_t  CRST       :  1;               /*!< Counter Reset                                                         */
    } TMRCTRL_b;                                    /*!< BitSize                                                               */
  };
  
  union {
    __IO uint32_t  TC;                              /*!< Offset:0x04 CT16Bn Timer Counter Register                             */
    
    struct {
      __IO uint32_t  TC         : 16;               /*!< Timer Counter                                                         */
    } TC_b;                                         /*!< BitSize                                                               */
  };
  
  union {
    __IO uint32_t  PRE;                             /*!< Offset:0x08 CT16Bn Prescale Register                                  */
    
    struct {
      __IO uint32_t  PR         : 16;               /*!< Prescaler                                                             */
    } PRE_b;                                        /*!< BitSize                                                               */
  };
  
  union {
    __IO uint32_t  PC;                              /*!< Offset:0x0C CT16Bn Prescale Counter Register                          */
    
    struct {
      __IO uint32_t  PC         : 16;               /*!< Prescaler Counter                                                     */
    } PC_b;                                         /*!< BitSize                                                               */
  };
  
  union {
    __IO uint32_t  CNTCTRL;                         /*!< Offset:0x10 CT16Bn Counter Control Register                           */
    
    struct {
      __IO uint32_t  CTM        :  2;               /*!< Counter/Timer Mode                                                    */
      __IO uint32_t  CIS        :  2;               /*!< Counter Input Select                                                  */
    } CNTCTRL_b;                                    /*!< BitSize                                                               */
  };
  
  union {
    __IO uint32_t  MCTRL;                           /*!< Offset:0x14 CT16Bn Match Control Register                             */
    
    struct {
      __IO uint32_t  MR0IE      :  1;               /*!< Enable generating an interrupt when MR0 matches TC                    */
      __IO uint32_t  MR0RST     :  1;               /*!< Enable reset TC when MR0 matches TC                                   */
      __IO uint32_t  MR0STOP    :  1;               /*!< Stop TC and PC and clear CEN bit when MR0 matches TC                  */
      __IO uint32_t  MR1IE      :  1;               /*!< Enable generating an interrupt when MR1 matches TC                    */
      __IO uint32_t  MR1RST     :  1;               /*!< Enable reset TC when MR1 matches TC                                   */
      __IO uint32_t  MR1STOP    :  1;               /*!< Stop TC and PC and clear CEN bit when MR1 matches TC                  */
      __IO uint32_t  MR2IE      :  1;               /*!< Enable generating an interrupt when MR2 matches TC                    */
      __IO uint32_t  MR2RST     :  1;               /*!< Enable reset TC when MR2 matches TC                                   */
      __IO uint32_t  MR2STOP    :  1;               /*!< Stop TC and PC and clear CEN bit when MR2 matches TC                  */
      __IO uint32_t  MR3IE      :  1;               /*!< Enable generating an interrupt when MR3 matches TC                    */
      __IO uint32_t  MR3RST     :  1;               /*!< Enable reset TC when MR3 matches TC                                   */
      __IO uint32_t  MR3STOP    :  1;               /*!< Stop TC and PC and clear CEN bit when MR3 matches TC                  */
    } MCTRL_b;                                      /*!< BitSize                                                               */
  };
	
  __IO uint32_t  MR0;                               /*!< Offset:0x18 CT16Bn MR0 Register                                       */
  __IO uint32_t  MR1;                               /*!< Offset:0x1C CT16Bn MR1 Register                                       */
  __IO uint32_t  MR2;                               /*!< Offset:0x20 CT16Bn MR2 Register                                       */
  __IO uint32_t  MR3;                               /*!< Offset:0x24 CT16Bn MR3 Register                                       */
  
  union {
    __IO uint32_t  CAPCTRL;                         /*!< Offset:0x28 CT16Bn Capture Control Register                           */
    
    struct {
      __IO uint32_t  CAP0RE     :  2;               /*!< Capture/Reset on CT16Bn_CAP0/Comparator capture output signal
                                                         rising edge                                                           */
      __IO uint32_t  CAP0FE     :  2;               /*!< Capture/Reset on CT16Bn_CAP0/Comoparator capture output signal
                                                         falling edge                                                          */
      __IO uint32_t  CAP0IE     :  1;               /*!< Interrupt on CT16Bn_CAP0/Comparator capture output signal event:
                                                         a CAP0 load due to a CT16Bn_CAP0/Comparator capture output signal
                                                          event will generate an interrupt.                                    */
      __IO uint32_t  CAP0EN     :  2;               /*!< CAP0 function enable bit                                              */
    } CAPCTRL_b;                                    /*!< BitSize                                                               */
  };
  
  union {
    __I  uint32_t  CAP0;                            /*!< Offset:0x2C CT16Bn CAP0 Register                                      */
    
    struct {
      __I  uint32_t  CAP0       : 16;               /*!< Timer counter capture value                                           */
    } CAP0_b;                                       /*!< BitSize                                                               */
  };
  
  union {
    __IO uint32_t  EM;                              /*!< Offset:0x30 CT16Bn External Match Register                            */
    
    struct {
      __IO uint32_t  EM0        :  1;               /*!< When the TC matches MR0, this bit will act according to EMC0[1:0],
                                                         and also drive the state of CT16Bn_PWM0 output.                       */
           uint32_t             :  3;
      __IO uint32_t  EMC0       :  2;               /*!< CT16Bn_PWM0 functionality                                             */
    } EM_b;                                         /*!< BitSize                                                               */
  };
  
  union {
    __IO uint32_t  PWMCTRL;                         /*!< Offset:0x34 CT16Bn PWM Control Register                               */
    
    struct {
      __IO uint32_t  PWM0EN     :  1;               /*!< PWM0 enable                                                           */
      __IO uint32_t  PWM1EN     :  1;               /*!< PWM1 enable                                                           */
           uint32_t             : 18;
      __IO uint32_t  PWM0IOEN   :  1;               /*!< CT16Bn_PWM0/GPIO selection                                            */
      __IO uint32_t  PWM1IOEN   :  1;               /*!< CT16Bn_PWM1/GPIO selection                                            */
    } PWMCTRL_b;                                    /*!< BitSize                                                               */
  };
  
  union {
    __I  uint32_t  RIS;                             /*!< Offset:0x38 CT16Bn Raw Interrupt Status Register                      */
    
    struct {
      __I  uint32_t  MR0IF      :  1;               /*!< Match channel 0 interrupt flag                                        */
      __I  uint32_t  MR1IF      :  1;               /*!< Match channel 1 interrupt flag                                        */
      __I  uint32_t  MR2IF      :  1;               /*!< Match channel 2 interrupt flag                                        */
      __I  uint32_t  MR3IF      :  1;               /*!< Match channel 3 interrupt flag                                        */
      __I  uint32_t  CAP0IF     :  1;               /*!< Capture channel 0 interrupt flag                                      */
    } RIS_b;                                        /*!< BitSize                                                               */
  };
  
  union {
    __O  uint32_t  IC;                              /*!< Offset:0x3C CT16Bn Interrupt Clear Register                           */
    
    struct {
      __O  uint32_t  MR0IC      :  1;               /*!< MR0IF clear bit                                                       */
      __O  uint32_t  MR1IC      :  1;               /*!< MR1IF clear bit                                                       */
      __O  uint32_t  MR2IC      :  1;               /*!< MR2IF clear bit                                                       */
      __O  uint32_t  MR3IC      :  1;               /*!< MR3IF clear bit                                                       */
      __O  uint32_t  CAP0IC     :  1;               /*!< CAP0IF clear bit                                                      */
    } IC_b;                                         /*!< BitSize                                                               */
  };
} SN_CT16B0_Type;


/* =========================================================================================================================== */
/* ====================================                    SN_CT32B0                   ======================================= */
/* =========================================================================================================================== */
/**
  * @brief 32-bit Timer 0 with Capture function (SN_CT32B0)
  */

typedef struct {                                    /*!< SN_CT32B0 Structure                                                   */
  
  union {
    __IO uint32_t  TMRCTRL;                         /*!< Offset:0x00 CT32Bn Timer Control Register                             */
    
    struct {
      __IO uint32_t  CEN        :  1;               /*!< Counter Enable                                                        */
      __IO uint32_t  CRST       :  1;               /*!< Counter Reset                                                         */
    } TMRCTRL_b;                                    /*!< BitSize                                                               */
  };
  __IO uint32_t  TC;                                /*!< Offset:0x04 CT32Bn Timer Counter Register                             */
  __IO uint32_t  PRE;                               /*!< Offset:0x08 CT32Bn Prescale Register                                  */
  __IO uint32_t  PC;                                /*!< Offset:0x0C CT32Bn Prescale Counter Register                          */
  
  union {
    __IO uint32_t  CNTCTRL;                         /*!< Offset:0x10 CT32Bn Counter Control Register                           */
    
    struct {
      __IO uint32_t  CTM        :  2;               /*!< Counter/Timer Mode                                                    */
      __IO uint32_t  CIS        :  2;               /*!< Counter Input Select                                                  */
    } CNTCTRL_b;                                    /*!< BitSize                                                               */
  };
  
  union {
    __IO uint32_t  MCTRL;                           /*!< Offset:0x14 CT32Bn Match Control Register                             */
    
    struct {
      __IO uint32_t  MR0IE      :  1;               /*!< Enable generating an interrupt when MR0 matches TC                    */
      __IO uint32_t  MR0RST     :  1;               /*!< Enable reset TC when MR0 matches TC                                   */
      __IO uint32_t  MR0STOP    :  1;               /*!< Stop TC and PC and clear CEN bit when MR0 matches TC                  */
      __IO uint32_t  MR1IE      :  1;               /*!< Enable generating an interrupt when MR1 matches TC                    */
      __IO uint32_t  MR1RST     :  1;               /*!< Enable reset TC when MR1 matches TC                                   */
      __IO uint32_t  MR1STOP    :  1;               /*!< Stop TC and PC and clear CEN bit when MR1 matches TC                  */
      __IO uint32_t  MR2IE      :  1;               /*!< Enable generating an interrupt when MR2 matches TC                    */
      __IO uint32_t  MR2RST     :  1;               /*!< Enable reset TC when MR2 matches TC                                   */
      __IO uint32_t  MR2STOP    :  1;               /*!< Stop TC and PC and clear CEN bit when MR2 matches TC                  */
      __IO uint32_t  MR3IE      :  1;               /*!< Enable generating an interrupt when MR3 matches TC                    */
      __IO uint32_t  MR3RST     :  1;               /*!< Enable reset TC when MR3 matches TC                                   */
      __IO uint32_t  MR3STOP    :  1;               /*!< Stop TC and PC and clear CEN bit when MR3 matches TC                  */
    } MCTRL_b;                                      /*!< BitSize                                                               */
  };
	
  __IO uint32_t  MR0;                               /*!< Offset:0x18 CT32Bn MR0 Register                                       */
  __IO uint32_t  MR1;                               /*!< Offset:0x1C CT32Bn MR1 Register                                       */
  __IO uint32_t  MR2;                               /*!< Offset:0x20 CT32Bn MR2 Register                                       */
  __IO uint32_t  MR3;                               /*!< Offset:0x24 CT32Bn MR3 Register                                       */
  
  union {
    __IO uint32_t  CAPCTRL;                         /*!< Offset:0x28 CT32Bn Capture Control Register                           */
    
    struct {
      __IO uint32_t  CAP0RE     :  2;               /*!< Capture/Reset on CT32Bn_CAP0/Comparator capture output signal
                                                         rising edge.                                                          */
      __IO uint32_t  CAP0FE     :  2;               /*!< Capture/Reset on CT32Bn_CAP0/Comparator capture output signal
                                                         falling edge.                                                         */
      __IO uint32_t  CAP0IE     :  1;               /*!< Interrupt on CT32Bn_CAP0/Comparator capture output event              */
      __IO uint32_t  CAP0EN     :  2;               /*!< Capture 0 function enable bit                                         */
    } CAPCTRL_b;                                    /*!< BitSize                                                               */
  };
  __I  uint32_t  CAP0;                              /*!< Offset:0x2C CT32Bn CAP0 Register                                      */
  
  union {
    __IO uint32_t  EM;                              /*!< Offset:0x30 CT32Bn External Match Register                            */
    
    struct {
      __IO uint32_t  EM0        :  1;               /*!< When the TC matches MR0, this bit will act according to EMC0[1:0],
                                                         and also drive the state of CT16Bn_PWM0 output.                       */
      __IO uint32_t  EM1        :  1;               /*!< When the TC matches MR1, this bit will act according to EMC1[1:0],
                                                         and also drive the state of CT16Bn_PWM1 output.                       */
           uint32_t             :  2;
      __IO uint32_t  EMC0       :  2;               /*!< CT32Bn_PWM0 functionality                                             */
      __IO uint32_t  EMC1       :  2;               /*!< CT32Bn_PWM1 functionality                                             */
    } EM_b;                                         /*!< BitSize                                                               */
  };
  
  union {
    __IO uint32_t  PWMCTRL;                         /*!< Offset:0x34 CT32Bn PWM Control Register                               */
    
    struct {
      __IO uint32_t  PWM0EN     :  1;               /*!< PWM0 enable                                                           */
      __IO uint32_t  PWM1EN     :  1;               /*!< PWM1 enable                                                           */
           uint32_t             : 18;
      __IO uint32_t  PWM0IOEN   :  1;               /*!< CT32Bn_PWM0/GPIO selection                                            */
      __IO uint32_t  PWM1IOEN   :  1;               /*!< CT16Bn_PWM1/GPIO selection                                            */
    } PWMCTRL_b;                                    /*!< BitSize                                                               */
  };
  
  union {
    __I  uint32_t  RIS;                             /*!< Offset:0x38 CT32Bn Raw Interrupt Status Register                      */
    
    struct {
      __I  uint32_t  MR0IF      :  1;               /*!< Match channel 0 interrupt flag                                        */
      __I  uint32_t  MR1IF      :  1;               /*!< Match channel 1 interrupt flag                                        */
      __I  uint32_t  MR2IF      :  1;               /*!< Match channel 2 interrupt flag                                        */
      __I  uint32_t  MR3IF      :  1;               /*!< Match channel 3 interrupt flag                                        */
      __I  uint32_t  CAP0IF     :  1;               /*!< Capture channel 0 interrupt flag                                      */
    } RIS_b;                                        /*!< BitSize                                                               */
  };
  
  union {
    __O  uint32_t  IC;                              /*!< Offset:0x3C CT32Bn Interrupt Clear Register                           */
    
    struct {
      __O  uint32_t  MR0IC      :  1;               /*!< MR0IF clear bit                                                       */
      __O  uint32_t  MR1IC      :  1;               /*!< MR1IF clear bit                                                       */
      __O  uint32_t  MR2IC      :  1;               /*!< MR2IF clear bit                                                       */
      __O  uint32_t  MR3IC      :  1;               /*!< MR3IF clear bit                                                       */
      __O  uint32_t  CAP0IC     :  1;               /*!< CAP0IF clear bit                                                      */
    } IC_b;                                         /*!< BitSize                                                               */
  };
} SN_CT32B0_Type;


/* =========================================================================================================================== */
/* ====================================                    SN_SPI                      ======================================= */
/* =========================================================================================================================== */
/**
  * @brief SPI (SN_SPI)
  */

typedef struct {                                    /*!< SN_SSP0 Structure                                                     */
  
  union {
    __IO uint32_t  CTRL0;                           /*!< Offset:0x00 SSPn Control Register 0                                   */
    
    struct {
      __IO uint32_t  SPIEN      :  1;               /*!< SSP enable                                                            */
      __IO uint32_t  LOOPBACK   :  1;               /*!< Loopback mode enable                                                  */
      __IO uint32_t  SDODIS     :  1;               /*!< Slave data out disable                                                */
      __IO uint32_t  MS         :  1;               /*!< Master/Slave selection                                                */
      __IO uint32_t  FORMAT     :  1;               /*!< Interface format                                                      */
           uint32_t             :  1;
      __O  uint32_t  FRESET     :  2;               /*!< SSP FSM and FIFO Reset                                                */
      __IO uint32_t  DL         :  4;               /*!< Data length = DL[3:0]+1                                               */
      __IO uint32_t  TXFIFOTH   :  3;               /*!< TX FIFO Threshold level                                               */
      __IO uint32_t  RXFIFOTH   :  3;               /*!< Rx FIFO Threshold level                                               */
      __IO uint32_t  SELDIS     :  1;               /*!< Auto-SEL disable bit                                                  */
      __IO uint32_t  SELCTRL    :  1;               /*!< Source for SEL pin                                                    */
    } CTRL0_b;                                      /*!< BitSize                                                               */
  };
  
  union {
    __IO uint32_t  CTRL1;                           /*!< Offset:0x04 SSPn Control Register 1                                   */
    
    struct {
      __IO uint32_t  MLSB       :  1;               /*!< MSB/LSB seletion                                                      */
      __IO uint32_t  CPOL       :  1;               /*!< Clock priority selection                                              */
      __IO uint32_t  CPHA       :  1;               /*!< Clock phase of edge sampling                                          */
    } CTRL1_b;                                      /*!< BitSize                                                               */
  };
  
  union {
    __IO uint32_t  CLKDIV;                          /*!< Offset:0x08 SSPn Clock Divider Register                               */
    
    struct {
      __IO uint32_t  DIV        :  8;               /*!< SSPn SCK=SSPn_PCLK/(2*DIV+2)                                          */
    } CLKDIV_b;                                     /*!< BitSize                                                               */
  };
  
  union {
    __I  uint32_t  STAT;                            /*!< Offset:0x0C SSPn Status Register                                      */
    
    struct {
      __I  uint32_t  TX_EMPTY   :  1;               /*!< TX FIFO empty flag                                                    */
      __I  uint32_t  TX_FULL    :  1;               /*!< TX FIFO full flag                                                     */
      __I  uint32_t  RX_EMPTY   :  1;               /*!< RX FIFO empty flag                                                    */
      __I  uint32_t  RX_FULL    :  1;               /*!< RX FIFO full flag                                                     */
      __I  uint32_t  BUSY       :  1;               /*!< Busy flag                                                             */
      __I  uint32_t  TXFIFOTHF  :  1;               /*!< TX FIFO threshold flag                                                */
      __I  uint32_t  RXFIFOTHF  :  1;               /*!< RX FIFO threshold flag                                                */
    } STAT_b;                                       /*!< BitSize                                                               */
  };
  
  union {
    __IO uint32_t  IE;                              /*!< Offset:0x10 SSPn Interrupt Enable Register                            */
    
    struct {
      __IO uint32_t  RXOVFIE    :  1;               /*!< RX FIFO overflow interrupt enable                                     */
      __IO uint32_t  RXTOIE     :  1;               /*!< RX time-out interrupt enable                                          */
      __IO uint32_t  RXFIFOTHIE :  1;               /*!< RX FIFO threshold interrupt enable                                    */
      __IO uint32_t  TXFIFOTHIE :  1;               /*!< TX FIFO threshold interrupt enable                                    */
    } IE_b;                                         /*!< BitSize                                                               */
  };
  
  union {
    __I  uint32_t  RIS;                             /*!< Offset:0x14 SSPn Raw Interrupt Status Register                        */
    
    struct {
      __I  uint32_t  RXOVFIF    :  1;               /*!< RX FIFO overflow interrupt flag                                       */
      __I  uint32_t  RXTOIF     :  1;               /*!< RX time-out interrupt flag                                            */
      __I  uint32_t  RXFIFOTHIF :  1;               /*!< RX FIFO threshold interrupt flag                                      */
      __I  uint32_t  TXFIFOTHIF :  1;               /*!< TX FIFO threshold interrupt flag                                      */
    } RIS_b;                                        /*!< BitSize                                                               */
  };
  
  union {
    __O  uint32_t  IC;                              /*!< Offset:0x18 SSPn Interrupt Clear Register                             */
    
    struct {
      __O  uint32_t  RXOVFIC    :  1;               /*!< RX FIFO overflow flag clear                                           */
      __O  uint32_t  RXTOIC     :  1;               /*!< RX time-out interrupt flag clear                                      */
      __O  uint32_t  RXFIFOTHIC :  1;               /*!< RX Interrupt flag Clear                                               */
      __O  uint32_t  TXFIFOTHIC :  1;               /*!< TX Interrupt flag Clear                                               */
    } IC_b;                                         /*!< BitSize                                                               */
  };
  
  union {
    __IO uint32_t  DATA;                            /*!< Offset:0x1C SSPn Data Register                                        */
    
    struct {
      __IO uint32_t  Data       : 16;               /*!< Data                                                                  */
    } DATA_b;                                       /*!< BitSize                                                               */
  };
} SN_SPI_Type;


/* =========================================================================================================================== */
/* ====================================                    SN_I2C                      ======================================= */
/* =========================================================================================================================== */
/**
  * @brief I2C (SN_I2C)
  */

typedef struct {                                    /*!< SN_I2C0 Structure                                                     */
  
  union {
    __IO uint32_t  CTRL;                            /*!< Offset:0x00 I2Cn Control Register                                     */
    
    struct {
           uint32_t             :  1;
      __IO uint32_t  NACK       :  1;               /*!< NACK assert flag                                                      */
      __IO uint32_t  ACK        :  1;               /*!< ACK assert flag                                                       */
           uint32_t             :  1;
      __IO uint32_t  STO        :  1;               /*!< STOP assert flag                                                      */
      __IO uint32_t  STA        :  1;               /*!< START assert flag                                                     */
           uint32_t             :  1;
      __IO uint32_t  I2CMODE    :  1;               /*!< I2C mode                                                              */
      __IO uint32_t  I2CEN      :  1;               /*!< I2Cn interface enable                                                 */
    } CTRL_b;                                       /*!< BitSize                                                               */
  };
  
  union {
    __IO uint32_t  STAT;                            /*!< Offset:0x04 I2Cn Status Register                                      */
    
    struct {
      __I  uint32_t  RX_DN      :  1;               /*!< RX done status                                                        */
      __I  uint32_t  ACK_STAT   :  1;               /*!< ACK done status                                                       */
      __I  uint32_t  NACK_STAT  :  1;               /*!< NACK done status                                                      */
      __I  uint32_t  STOP_DN    :  1;               /*!< STOP done status                                                      */
      __I  uint32_t  START_DN   :  1;               /*!< START done status                                                     */
      __I  uint32_t  I2C_MST    :  1;               /*!< I2C master/slave status                                               */
      __I  uint32_t  SLV_RX_HIT :  1;               /*!< Slave RX address hit flag                                             */
      __I  uint32_t  SLV_TX_HIT :  1;               /*!< Slave TX address hit flag                                             */
      __I  uint32_t  LOST_ARB   :  1;               /*!< Lost arbitration status                                               */
      __I  uint32_t  TIMEOUT    :  1;               /*!< Time-out status                                                       */
           uint32_t             :  5;
      __IO uint32_t  I2CIF      :  1;               /*!< I2C interrupt flag                                                    */
    } STAT_b;                                       /*!< BitSize                                                               */
  };
  
  union {
    __IO uint32_t  TXDATA;                          /*!< Offset:0x08 I2Cn TX Data Register                                     */
    
    struct {
      __IO uint32_t  Data       :  8;               /*!< TX Data                                                               */
    } TXDATA_b;                                     /*!< BitSize                                                               */
  };
  
  union {
    __I  uint32_t  RXDATA;                          /*!< Offset:0x0C I2Cn RX Data Register                                     */
    
    struct {
      __I  uint32_t  Data       :  8;               /*!< RX Data received when RX_DN=1                                         */
    } RXDATA_b;                                     /*!< BitSize                                                               */
  };
  
  union {
    __IO uint32_t  SLVADDR0;                        /*!< Offset:0x10 I2Cn Slave Address 0 Register                             */
    
    struct {
      __IO uint32_t  ADDR       : 10;               /*!< I2Cn slave address 0                                                  */
           uint32_t             : 20;
      __IO uint32_t  GCEN       :  1;               /*!< General call address enable                                           */
      __IO uint32_t  ADD_MODE   :  1;               /*!< Slave address mode                                                    */
    } SLVADDR0_b;                                   /*!< BitSize                                                               */
  };
  
  union {
    __IO uint32_t  SLVADDR1;                        /*!< Offset:0x14 I2Cn Slave Address 1 Register                             */
    
    struct {
      __IO uint32_t  ADDR       : 10;               /*!< I2Cn slave address 1                                                  */
    } SLVADDR1_b;                                   /*!< BitSize                                                               */
  };
  
  union {
    __IO uint32_t  SLVADDR2;                        /*!< Offset:0x18 I2Cn Slave Address 2 Register                             */
    
    struct {
      __IO uint32_t  ADDR       : 10;               /*!< I2Cn slave address 2                                                  */
    } SLVADDR2_b;                                   /*!< BitSize                                                               */
  };
  
  union {
    __IO uint32_t  SLVADDR3;                        /*!< Offset:0x1C I2Cn Slave Address 3 Register                             */
    
    struct {
      __IO uint32_t  ADDR       : 10;               /*!< I2Cn slave address 3                                                  */
    } SLVADDR3_b;                                   /*!< BitSize                                                               */
  };
  
  union {
    __IO uint32_t  SCLHT;                           /*!< Offset:0x20 I2Cn SCL High Time Register                               */
    
    struct {
      __IO uint32_t  SCLH       :  16;               /*!< SCLn High period time=(SCLHT+1)*I2Cn_PCLK cycle                      */
    } SCLHT_b;                                      /*!< BitSize                                                               */
  };
  
  union {
    __IO uint32_t  SCLLT;                           /*!< Offset:0x24 I2Cn SCL Low Time Register                                */
    
    struct {
      __IO uint32_t  SCLL       :  16;               /*!< SCLn Low period time=(SCLLT+1)*I2Cn_PCLK cycle                       */
    } SCLLT_b;                                      /*!< BitSize                                                               */
  };
  __I  uint32_t  RESERVED0;
  
  union {
    __IO uint32_t  TOCTRL;                          /*!< Offset:0x2C I2Cn Timeout Control Register                             */
    
    struct {
      __IO uint32_t  TO         : 16;               /*!< Timeout period time = TO*I2Cn_PCLK cycle                              */
    } TOCTRL_b;                                     /*!< BitSize                                                               */
  };
  
  union {
    __IO uint32_t  MMCTRL;                          /*!< Offset:0x30 I2Cn Monitor Mode Control Register                        */
    
    struct {
      __IO uint32_t  MMEN       :  1;               /*!< Monitor mode enable                                                   */
      __IO uint32_t  SCLOEN     :  1;               /*!< SCLn output enable                                                    */
      __IO uint32_t  MATCH_ALL  :  1;               /*!< Match address selection                                               */
    } MMCTRL_b;                                     /*!< BitSize                                                               */
  };
	
	union {
    __IO uint32_t  EMODE;                          /*!< Offset:0x34 I2Cn Engineer Mode Register                                */
    
    struct {
      __IO uint32_t  ICOD       :  1;               /*!< I2C Open Drain enable                                                 */
      __IO uint32_t  SLVSTAEN   :  1;               /*!< Slave START Enable                                                    */
    } EMODE_b;                                      /*!< BitSize                                                               */
  };
} SN_I2C_Type;


/* =========================================================================================================================== */
/* ====================================                    SN_UART                     ======================================= */
/* =========================================================================================================================== */
/**
  * @brief UART (SN_UART)
  */

typedef struct {                                    /*!< SN_UART0 Structure                                                    */
  
  union {
    union {
      __IO uint32_t  DLL;                           /*!< Offset:0x00 UARTn Divisor Latch LSB Register                          */
      
      struct {
        __IO uint32_t  DLL      :  8;               /*!< DLL and DLM register determines the baud rate of UARTn                */
      } DLL_b;                                      /*!< BitSize                                                               */
    };
    
    union {
      __O  uint32_t  TH;                            /*!< Offset:0x00 UARTn Transmit Holding Register                           */
      
      struct {
        __O  uint32_t  TH       :  8;               /*!< The oldest byte to be transmitted in UART TX FIFO when transmitter
                                                         is available                                                          */
      } TH_b;                                       /*!< BitSize                                                               */
    };
    
    union {
      __I  uint32_t  RB;                            /*!< Offset:0x00 UARTn Receiver Buffer Register                            */
      
      struct {
        __I  uint32_t  RB       :  8;               /*!< The oldest received byte in UART RX FIFO                              */
      } RB_b;                                       /*!< BitSize                                                               */
    };
  } ;
  
  union {
    union {
      __IO uint32_t  IE;                            /*!< Offset:0x04 UARTn Interrupt Enable Register                           */
      
      struct {
        __IO uint32_t  RDAIE    :  1;               /*!< RDA interrupt enable                                                  */
        __IO uint32_t  THREIE   :  1;               /*!< THRE interrupt enable                                                 */
        __IO uint32_t  RLSIE    :  1;               /*!< RLS interrupt enable                                                  */
             uint32_t           :  1;
        __IO uint32_t  TEMTIE   :  1;               /*!< TEMT interrupt enable                                                 */
             uint32_t           :  3;
        __IO uint32_t  ABEOIE   :  1;               /*!< ABE0 interrupt enable                                                 */
        __IO uint32_t  ABTOIE   :  1;               /*!< ABT0 interrupt enable                                                 */
      } IE_b;                                       /*!< BitSize                                                               */
    };
    
    union {
      __IO uint32_t  DLM;                           /*!< Offset:0x04 UARTn Divisor Latch MSB Register                          */
      
      struct {
        __IO uint32_t  DLM      :  8;               /*!< DLL and DLM register determines the baud rate of UARTn                */
      } DLM_b;                                      /*!< BitSize                                                               */
    };
  } ;
  
  union {
    union {
      __O  uint32_t  FIFOCTRL;                      /*!< Offset:0x08 UARTn FIFO Control Register                               */
      
      struct {
        __O  uint32_t  FIFOEN   :  1;               /*!< FIFO enable                                                           */
        __O  uint32_t  RXFIFORST:  1;               /*!< RX FIFO reset                                                         */
        __O  uint32_t  TXFIFORST:  1;               /*!< TX FIFO reset                                                         */
             uint32_t           :  3;
        __O  uint32_t  RXTL     :  2;               /*!< RX trigger level                                                      */
      } FIFOCTRL_b;                                 /*!< BitSize                                                               */
    };
    
    union {
      __I  uint32_t  II;                            /*!< Offset:0x08 UARTn Interrupt Identification Register                   */
      
      struct {
        __I  uint32_t  INTSTATUS:  1;               /*!< Interrupt status                                                      */
        __I  uint32_t  INTID    :  3;               /*!< Interrupt ID of RX FIFO                                               */
             uint32_t           :  2;
        __I  uint32_t  FIFOEN   :  2;               /*!< Equal to FIFOEN bits in UARTn_FIFOCTRL register                       */
        __I  uint32_t  ABEOIF   :  1;               /*!< ABEO interrupt flag                                                   */
        __I  uint32_t  ABTOIF   :  1;               /*!< ABTO interrupt flag                                                   */
      } II_b;                                       /*!< BitSize                                                               */
    };
  } ;
  
  union {
    __IO uint32_t  LC;                              /*!< Offset:0x0C UARTn Line Control Register                               */
    
    struct {
      __IO uint32_t  WLS        :  2;               /*!< Word length selection                                                 */
      __IO uint32_t  SBS        :  1;               /*!< Stop bit selection                                                    */
      __IO uint32_t  PE         :  1;               /*!< Parity enable                                                         */
      __IO uint32_t  PS         :  2;               /*!< Parity selection                                                      */
      __IO uint32_t  BC         :  1;               /*!< Break control                                                         */
      __IO uint32_t  DLAB       :  1;               /*!< Divisor Latch access                                                  */
    } LC_b;                                         /*!< BitSize                                                               */
  };
  __I  uint32_t  RESERVED0;
  
  union {
    __I  uint32_t  LS;                              /*!< Offset:0x14 UARTn Line Status Register                                */
    
    struct {
      __I  uint32_t  RDR        :  1;               /*!< Receiver data ready flag                                              */
      __I  uint32_t  OE         :  1;               /*!< Overrun error flag                                                    */
      __I  uint32_t  PE         :  1;               /*!< Parity error flag                                                     */
      __I  uint32_t  FE         :  1;               /*!< Framing error flag                                                    */
      __I  uint32_t  BI         :  1;               /*!< Break interrupt flag                                                  */
      __I  uint32_t  THRE       :  1;               /*!< THR empty flag                                                        */
      __I  uint32_t  TEMT       :  1;               /*!< Transmitter empty flag                                                */
      __I  uint32_t  RXFE       :  1;               /*!< Receiver FIFO error flag                                              */
    } LS_b;                                         /*!< BitSize                                                               */
  };
  __I  uint32_t  RESERVED1;
  
  union {
    __IO uint32_t  SP;                              /*!< Offset:0x1C UARTn Scratch Pad Register                                */
    
    struct {
      __IO uint32_t  PAD        :  8;               /*!< Pad informaton                                                        */
    } SP_b;                                         /*!< BitSize                                                               */
  };
  
  union {
    __IO uint32_t  ABCTRL;                          /*!< Offset:0x20 UARTn Auto-baud Control Register                          */
    
    struct {
      __IO uint32_t  START      :  1;               /*!< Auto-baud run bit                                                     */
      __IO uint32_t  MODE       :  1;               /*!< Auto-baud mode selection                                              */
      __IO uint32_t  AUTORESTART:  1;               /*!< Restart mode selection                                                */
           uint32_t             :  5;
      __O  uint32_t  ABEOIFC    :  1;               /*!< Clear ABEOIF flag                                                     */
      __O  uint32_t  ABTOIFC    :  1;               /*!< Clear ABTOIF flag                                                     */
    } ABCTRL_b;                                     /*!< BitSize                                                               */
  };
  __I  uint32_t  RESERVED2;
  
  union {
    __IO uint32_t  FD;                              /*!< Offset:0x28 UARTn Fractional Divider Register                         */
    
    struct {
      __IO uint32_t  DIVADDVAL  :  4;               /*!< Baud rate generation prescaler divisor value                          */
      __IO uint32_t  MULVAL     :  4;               /*!< Baud rate generation prescaler multiplier value                       */
      __IO uint32_t  OVER8      :  1;               /*!< Oversampling value                                                    */
    } FD_b;                                         /*!< BitSize                                                               */
  };
  __I  uint32_t  RESERVED3;
  
  union {
    __IO uint32_t  CTRL;                            /*!< Offset:0x30 UARTn Control Register                                    */
    
    struct {
      __IO uint32_t  UARTEN     :  1;               /*!< UART enable                                                           */
           uint32_t             :  5;
      __IO uint32_t  RXEN       :  1;               /*!< RX enable                                                             */
      __IO uint32_t  TXEN       :  1;               /*!< TX enable                                                             */
    } CTRL_b;                                       /*!< BitSize                                                               */
  };
  
  union {
    __IO uint32_t  HDEN;                            /*!< Offset:0x34 UARTn Control Register                                    */
    
    struct {
      __IO uint32_t  HDEN       :  1;               /*!< Half-duplex mode enable                                               */
    } HDEN_b;                                       /*!< BitSize                                                               */
  };
} SN_UART_Type;


/* =========================================================================================================================== */
/* ====================================                    SN_I2S                      ======================================= */
/* =========================================================================================================================== */
/**
  * @brief I2S (SN_I2S)
  */

typedef struct {                                    /*!< SN_I2S Structure                                                      */
  
  union {
    __IO uint32_t  CTRL;                            /*!< Offset:0x00 I2S Control Register                                      */
    
    struct {
      __IO uint32_t  START      :  1;               /*!< Start Transmit/Receive                                                */
      __IO uint32_t  MUTE       :  1;               /*!< Mute enable                                                           */
      __IO uint32_t  MONO       :  1;               /*!< Mono/stereo selection                                                 */
      __IO uint32_t  MS         :  1;               /*!< Master/Slave selection bit                                            */
      __IO uint32_t  FORMAT     :  2;               /*!< I2S operation format                                                  */
      __IO uint32_t  TXEN       :  1;               /*!< Transmit enable bit                                                   */
      __O  uint32_t  RXEN       :  1;               /*!< Receiver enable bit                                                   */
      __O  uint32_t  CLRTXFIFO  :  1;               /*!< Clear I2S TX FIFO                                                     */
      __O  uint32_t  CLRRXFIFO  :  1;               /*!< Clear I2S RX FIFO                                                     */
      __IO uint32_t  DL         :  2;               /*!< Data length                                                           */
      __IO uint32_t  PAUSE		:  1;               /*!< PAUSE Mode                                                    		*/
      __IO uint32_t             :  7;
      __IO uint32_t  CHLENGTH   :  5;               /*!< Bit number of single channel                                          */
      __IO uint32_t             :  4;
      __IO uint32_t  ADCEN      :  1;               /*!< ADC enable                                                            */
	  __IO uint32_t  DACEN      :  1;               /*!< DAC enable                                                            */
      __IO uint32_t  I2SEN      :  1;               /*!< I2S enable                                                            */
    } CTRL_b;                                       /*!< BitSize                                                               */
  };
  
  union {
    __IO uint32_t  CLK;                             /*!< Offset:0x04 I2S Clock Register                                        */
    
    struct {
      __IO uint32_t  MCLKDIV    :  3;               /*!< MCLK divider                                                          */
      __IO uint32_t  MCLKOEN    :  1;               /*!< MLCK output enable                                                    */
      __IO uint32_t  MCLKSEL    :  1;               /*!< MLCK source selection                                                 */
           uint32_t             :  3;
      __IO uint32_t  BCLKDIV    :  8;               /*!< BCLK divider                                                          */
	  __IO uint32_t  FPLLDIV    :  2;               /*!< Fractional PLL divider                                                */
    } CLK_b;                                        /*!< BitSize                                                               */
  };
  
  union {
    __I  uint32_t  STATUS;                          /*!< Offset:0x08 I2S Status Register                                       */
    
    struct {
      __I  uint32_t  TX_TOG     :  1;               /*!< TX Toggle                                                             */
      __I  uint32_t  RX_TOG     :  1;               /*!< Rx Toggle                                                             */
    } STATUS_b;                                     /*!< BitSize                                                               */
  };
  
  union {
    __IO uint32_t  IE;                              /*!< Offset:0x0C I2S Interrupt Enable Register                             */
    
    struct {
      __IO uint32_t  TXINTEN:  1;                   /*!< TX interrupt enable                                                   */
      __IO uint32_t  RXINTEN:  1;                   /*!< RX interrupt enable                                                   */
    } IE_b;                                         /*!< BitSize                                                               */
  };
  
  
	__O  uint32_t  TXRAMLENGTH;						/*!< Offset:0x10	                                                         */ 
	
	     uint32_t  Reserved1;						/*!< Offset:0x14	                                                         */ 
	     uint32_t  Reserved2;						/*!< Offset:0x18	                                                         */
	     uint32_t  Reserved3;						/*!< Offset:0x1C	                                                         */
	
	__O  uint32_t  TXRAMADR;						/*!< Offset:0x20	                                                         */
	
  	__O  uint32_t  TXRAMADRRCHOFST;					/*!< Offset:0x24	                                                         */
  
  	__I  uint32_t  TX_RAM_IDX;						/*!< Offset:0x28	                                                         */
   
	     uint32_t  Reserved4;						/*!< Offset:0x2C	                                                         */
	
  	__O  uint32_t  RXRAMADR;						/*!< Offset:0x30	                                                         */

  	__O  uint32_t  RXRAMADRRCHOFST;					/*!< Offset:0x34	                                                         */
	
	__I  uint32_t  RX_RAM_IDX;						/*!< Offset:0x38	                                                         */	
  
} SN_I2S_Type;


/* =========================================================================================================================== */
/* ====================================                    SN_I2S2                     ======================================= */
/* =========================================================================================================================== */
/**
  * @brief I2S_2 (SN_I2S_2)
  */

typedef struct {                                    /*!< SN_I2S_2 Structure                                                    */
  
  union {
    __IO uint32_t  CTRL;                            /*!< Offset:0x00 I2S Control Register                                      */
    
    struct {
      __IO uint32_t  START      :  1;               /*!< Start Transmit/Receive                                                */
      __IO uint32_t  MUTE       :  1;               /*!< Mute enable                                                           */
      __IO uint32_t  MONO       :  1;               /*!< Mono/stereo selection                                                 */
      __IO uint32_t  MS         :  1;               /*!< Master/Slave selection bit                                            */
      __IO uint32_t  FORMAT     :  2;               /*!< I2S operation format                                                  */
      __IO uint32_t  TXEN       :  1;               /*!< Transmit enable bit                                                   */
      __O  uint32_t  RXEN       :  1;               /*!< Receiver enable bit                                                   */
      __O  uint32_t  CLRTXFIFO  :  1;               /*!< Clear I2S TX FIFO                                                     */
      __O  uint32_t  CLRRXFIFO  :  1;               /*!< Clear I2S RX FIFO                                                     */
      __IO uint32_t  DL         :  2;               /*!< Data length                                                           */
      __IO uint32_t  TXFIFOTH   :  3;               /*!< Tx FIFO threshold level                                               */
           uint32_t             :  1;
      __IO uint32_t  RXFIFOTH   :  3;               /*!< Rx FIFO threshold level                                               */
           uint32_t             :  1;
      __IO uint32_t  CHLENGTH   :  5;               /*!< Bit number of single channel                                          */
           uint32_t             :  5;
      __IO uint32_t  I2SMOD     :  1;               /*!< I2S mode select bit                                                   */
      __IO uint32_t  I2SEN      :  1;               /*!< I2S enable                                                            */
    } CTRL_b;                                       /*!< BitSize                                                               */
  };
  
  union {
    __IO uint32_t  CLK;                             /*!< Offset:0x04 I2S Clock Register                                        */
    
    struct {
      __IO uint32_t  MCLKDIV    :  3;               /*!< MCLK divider                                                          */
      __IO uint32_t  MCLKOEN    :  1;               /*!< MLCK output enable                                                    */
      __IO uint32_t  MCLKSEL    :  1;               /*!< MLCK source selection                                                 */
           uint32_t             :  3;
      __IO uint32_t  BCLKDIV    :  8;               /*!< BCLK divider                                                          */
			__IO uint32_t  FPLLDIV    :  2;               /*!< Fractional PLL divider                                          */
    } CLK_b;                                        /*!< BitSize                                                               */
  };
  
  union {
    __I  uint32_t  STATUS;                          /*!< Offset:0x08 I2S Status Register                                       */
    
    struct {
      __I  uint32_t  I2SINT     :  1;               /*!< I2S interrupt flag                                                    */
      __I  uint32_t  RIGHTCH    :  1;               /*!< Current channel status                                                */
           uint32_t             :  4;
      __I  uint32_t  TXFIFOTHF  :  1;               /*!< TX FIFO threshold flag                                                */
      __I  uint32_t  RXFIFOTHF  :  1;               /*!< RX FIFO threshold flag                                                */
      __I  uint32_t  TXFIFOFULL :  1;               /*!< TX FIFO full flag                                                     */
      __I  uint32_t  RXFIFOFULL :  1;               /*!< RX FIFO full flag                                                     */
      __I  uint32_t  TXFIFOEMPTY:  1;               /*!< TX FIFO empty flag                                                    */
      __I  uint32_t  RXFIFOEMPTY:  1;               /*!< RX FIFO empty flag                                                    */
      __I  uint32_t  TXFIFOLV   :  4;               /*!< TX FIFO used level                                                    */
           uint32_t             :  1;
      __I  uint32_t  RXFIFOLV   :  4;               /*!< RX FIFO used level                                                    */
    } STATUS_b;                                     /*!< BitSize                                                               */
  };
  
  union {
    __IO uint32_t  IE;                              /*!< Offset:0x0C I2S Interrupt Enable Register                             */
    
    struct {
           uint32_t             :  4;
      __IO uint32_t  TXFIFOOVFIEN:  1;              /*!< TX FIFO overflow interrupt enable                                     */
      __IO uint32_t  RXFIFOUDFIEN:  1;              /*!< RX FIFO underflow interrupt enable                                    */
      __IO uint32_t  TXFIFOTHIEN:  1;               /*!< TX FIFO threshold interrupt enable                                    */
      __IO uint32_t  RXFIFOTHIEN:  1;               /*!< RX FIFO threshold interrupt enable                                    */
    } IE_b;                                         /*!< BitSize                                                               */
  };
  
  union {
    __I  uint32_t  RIS;                             /*!< Offset:0x10 I2S Raw Interrupt Status Register                         */
    
    struct {
           uint32_t             :  4;
      __I  uint32_t  TXFIFOOVIF :  1;               /*!< TX FIFO overflow interrupt flag                                       */
      __I  uint32_t  RXFIFOUDIF :  1;               /*!< RX FIFO underflow interrupt flag                                      */
      __I  uint32_t  TXFIFOTHIF :  1;               /*!< TX FIFO threshold interrupt flag                                      */
      __I  uint32_t  RXFIFOTHIF :  1;               /*!< RX FIFO threshold interrupt flag                                      */
    } RIS_b;                                        /*!< BitSize                                                               */
  };
  
  union {
    __O  uint32_t  IC;                              /*!< Offset:0x14 I2S Interrupt Clear Register                              */
    
    struct {
           uint32_t             :  4;
      __O  uint32_t  TXFIFOOVIC :  1;               /*!< TX FIFO overflow interrupt clear                                      */
      __O  uint32_t  RXFIFOUDIC :  1;               /*!< RX FIFO underflow interrupt clear                                     */
      __O  uint32_t  TXFIFOTHIC :  1;               /*!< TX FIFO threshold interrupt clear                                     */
      __O  uint32_t  RXFIFOTHIC :  1;               /*!< RX FIFO threshold interrupt clear                                     */
    } IC_b;                                         /*!< BitSize                                                               */
  };
	
	__I  uint32_t  RXFIFO;                          	/*!< Offset:0x18 UARTn RX FIFO Register                                    */
	__O  uint32_t  TXFIFO;                            /*!< Offset:0x1C UARTn TX FIFO Register                                    */
	
  
} SN_I2S2_Type;

/* =========================================================================================================================== */
/* ====================================                    SN_ADC                      ======================================= */
/* =========================================================================================================================== */


/**
  * @brief Codec ADC Control Registers (SN_ADC)
  */

typedef struct {                                    /*!< SN_ADC Structure                                                      */
  __I  uint32_t  RESERVED0[388];

//	__IO uint32_t		SET54;				 										//!< Offset:0x540 ADC Setting 54 Register
//	__I  uint32_t		RESERVED54[3];														
//																	
//	__IO uint32_t		SET55;				 										//!< Offset:0x550 ADC Setting 55 Register
//	__I  uint32_t		RESERVED55[3];														
//																	
//	__IO uint32_t		SET56;				 										//!< Offset:0x560 ADC Setting 56 Register
//	__I  uint32_t		RESERVED56[3];														
//																	
//	__IO uint32_t		SET57;				 										//!< Offset:0x570 ADC Setting 57 Register
//	__I  uint32_t		RESERVED57[3];														
//																	
//	__IO uint32_t		SET58;				 										//!< Offset:0x580 ADC Setting 58 Register
//	__I  uint32_t		RESERVED58[3];														
//																	
//	__IO uint32_t		SET59;				 										//!< Offset:0x590 ADC Setting 59 Register
//	__I  uint32_t		RESERVED59[3];														
//																	
//	__IO uint32_t		SET5A;				 										//!< Offset:0x5A0 ADC Setting 5A Register
//	__I  uint32_t		RESERVED5A[3];														
//																	
//	__IO uint32_t		SET5B;				 										//!< Offset:0x5B0 ADC Setting 5B Register
//	__I  uint32_t		RESERVED5B[3];														
//																	
//	__IO uint32_t		SET5C;				 										//!< Offset:0x5C0 ADC Setting 5C Register
//	__I  uint32_t		RESERVED5C[3];														
//																	
//	__IO uint32_t		SET5D;				 										//!< Offset:0x5D0 ADC Setting 5D Register
//	__I  uint32_t		RESERVED5D[3];														
//																	
//	__IO uint32_t		SET5E;				 										//!< Offset:0x5E0 ADC Setting 5E Register
//	__I  uint32_t		RESERVED5E[3];														
//																	
//	__IO uint32_t		SET5F;				 										//!< Offset:0x5F0 ADC Setting 5F Register
//	__I  uint32_t		RESERVED5F[3];														
//																	
//	__IO uint32_t		SET60;				 										//!< Offset:0x600 ADC Setting 60 Register
//	__I  uint32_t		RESERVED60[3];														
																	
	union {
    __IO uint32_t		SET61;				 										//!< Offset:0x610 ADC Setting 62 Register
		struct {
      __IO uint32_t  PGA_SET_VAL   :  5;               /*!< AGC Control. PGA setting value at normal mode when AGC is on.    */
      __IO uint32_t  BOOST_SET_VAL :  2;               /*!< AGC Control. Boost setting value at normal mode when AGC is on.  */
			__IO uint32_t  AGC_OFF       :  1;               /*!< AGC Control. AGC function control.                               */
    } SET61_b;                                      /*!< BitSize                                                             */
  };
	__I  uint32_t		RESERVED61[3];														
																	
	union {
    __IO uint32_t		SET62;				 										//!< Offset:0x620 ADC Setting 62 Register
		struct {
      __IO uint32_t  IWL        :  2;               /*!< World length of DAI                                                   */
      __IO uint32_t  ACTIVE     :  1;               /*!< Digital Audio Interface Control                                       */
    } SET62_b;                                      /*!< BitSize                                                               */
  };
	__I  uint32_t		RESERVED62[3];														
																	
	union {
    __IO uint32_t  SET63;                           /*!< Offset:0x630 ADC Setting 63 Register                                  */
    
    struct {
      __IO uint32_t  PGA       :  5;              /*!< PGA setting value when AGC is off(1.5dB/step)                           */
      __IO uint32_t  BOOST     :  2;              /*!< Boost setting value when AGC is off                                     */
    } SET63_b;                                      /*!< BitSize                                                               */
  };
	__I  uint32_t		RESERVED63[3];														
																	
	union {
    __IO uint32_t  SET64;                           /*!< Offset:0x640 ADC Setting 6E Register                                  */
    
    struct {
      __IO uint32_t  HPGAIN       :  4;             /*!< HPF GAIN                                                              */
      __IO uint32_t  ADCHPD       :  1;             /*!< HPF function for DC offset cancellation                               */
      __IO uint32_t  FILTER_OFF   :  1;             /*!< Filter function for noise suppression                                 */
    } SET64_b;                                      /*!< BitSize                                                               */
  };
	__I  uint32_t		RESERVED64[3];														
																	
	union {
    __IO uint32_t  SET65;                           /*!< Offset:0x650 ADC Setting 65 Register                                  */
    
    struct {
      __IO uint32_t  MUTE_CTRL    :  4;             /*!< Digital volume attenuation control at mute mode                       */
      __IO uint32_t  VOL_CTRL     :  4;             /*!< Digital volume attenuation control at normal mode                     */
    } SET65_b;                                      /*!< BitSize                                                               */
  };
	__I  uint32_t		RESERVED65[3];														
																	
	__IO uint32_t		SET66;				 										//!< Offset:0x660 ADC Setting 66 Register
	__I  uint32_t		RESERVED66[3];														
																	
	__IO uint32_t		SET67;				 										//!< Offset:0x670 ADC Setting 67 Register
	__I  uint32_t		RESERVED67[3];														
																	
	__IO uint32_t		SET68;				 										//!< Offset:0x680 ADC Setting 68 Register
	__I  uint32_t		RESERVED68[3];														

	__IO uint32_t		SET69;				 										//!< Offset:0x690 ADC Setting 69 Register
	__I  uint32_t		RESERVED69[3];	

	__IO uint32_t		SET6A;				 										//!< Offset:0x6A0 ADC Setting 6A Register
	__I  uint32_t		RESERVED6A[3];	
																	
	union {
    __IO uint32_t		SET6B;				 										//!< Offset:0x6B0 ADC Setting 6B Register
		struct {
			__I  uint32_t  RESERVED1    :  3;               /*!<																																			 */
  		__IO uint32_t  DEMPD        :  1;               //*!< DEM disable, active 'High'                                           */
      __IO uint32_t  PGA_EN       :  1;               //*!< PGA power-up enable, active 'High'                                   */
      __IO uint32_t  MICBT_EN     :  1;               //*!< MICBOOST power-up enable, active 'High'                              */
			__I  uint32_t  RESERVED2    :  1;               /*!<																																			 */
			__IO uint32_t  ADC_EN       :  1;               //*!< ADC power-up enable, active 'High'                                   */  		
    } SET6B_b;                                      /*!< BitSize                                                               */
  };
	__I  uint32_t		RESERVED6B[3];				

  union {
    __IO uint32_t  SET6C;                           /*!< Offset:0x6C0 ADC Setting 6C Register                                  */
    
    struct {
      __IO uint32_t  CK_EN      :  1;               /*!< CKGEN enable                                                          */
      __IO uint32_t  MICB_EN    :  1;            		/*!< Microphone bias enable, active 'High'                                 */
      __IO uint32_t  VREF_EN    :  1;               /*!< VREF circuit enable, active 'High'                                    */
      __IO uint32_t  IREF_EN    :  1;               /*!< IREF circuit enable, active 'High'                                    */
      __IO uint32_t  DX_EN      :  1;               /*!< SDM data to IC external enable, active 'High'                         */
      __IO uint32_t  CS         :  2;           		/*!< Chopper frequency select                                              */				
    } SET6C_b;                                      	/*!< Left Channel BitSize                                                */
  };
  __I  uint32_t  RESERVED6C[3];
	
	union {
    __IO uint32_t  SET6D;                           /*!< Offset:0x6D0 ADC Setting 6D Register                                  */
    
    struct {
			__IO uint32_t  SEL_MIX_MIC    :  1;               /*!< Microphone input path to mixer enable                          */
      __I  uint32_t  RESERVED1      :  1;               /*!<																			                          */
      __IO uint32_t  SEL_MIC        :  1;               /*!< Microphone input structure select                              */
      __I  uint32_t  RESERVED2      :  1;               /*!<																																*/
			__IO uint32_t  SEL_MICB       :  1;               /*!< Microphone Bias Output select                                  */ 
			__IO uint32_t  SEL_IB         :  2;               /*!< Internal Bias Current select                                   */			
    } SET6D_b;                                     		/*!< Right Channel BitSize                                               */
  };
  __I  uint32_t  RESERVED6D[3];

	__IO uint32_t	 SET6E;				 										//!< Offset:0x6E0 ADC Setting 60 Register
  __I  uint32_t  RESERVED6E[3];
	  																   	
} SN_ADC_Type;


/* =========================================================================================================================== */
/* ====================================                    SN_DAC                      ======================================= */
/* =========================================================================================================================== */
/**
  * @brief Codec DAC Control Registers (SN_DAC)
  */
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
