jianweizou/fun/code/fun_20180702/Code/led.h

#define LED_WHITE	1
#define LED_RGB		2

#define LEDR	1
#define LEDG	2
#define LEDB	4

#define LED1	1
#define LED2	2
#define LED3	4
#define LED4	8

void Init_LED(void);
void DeInit_LED(void);
void LED_Process(unsigned char led_stage);
void LED_WHITE_Setting(unsigned char led_value);
void LED_RGB_Setting(unsigned char led_value);
unsigned char batlevel_to_led_value(unsigned char stage);
void LED_Setting(unsigned char led_stage);
