jianweizou/fun/code/sonix evb/3.SN7312_IIC_OLED/src/count.h

#include <stdio.h>
#include "SNC7312.h"
#include "system_snc7312.h"

#include "OLED.h"

#define BASEYEAR	2017

typedef enum 
{
	CHINESE=0,
	ENGLISH,
}LANGUAGE;

typedef enum 
{
	ARABNUM=0,//123
	TIBENUM,//Tibetan number	
}NUMTYPE;

typedef enum
{
	YEAR,
	MONTH,
	DAY,
}DATE_TYPE;

typedef enum 
{
	SYSINIT,
	SELECT_LANGUAGE,
	SELECT_DATE,
	SELECT_NUMTYPE,
	CNT_STAGE,
	RST_CNT,
	RST_SYS,
}SYSLOOP;

typedef struct
{
	unsigned char Year;
	unsigned char Month;
	unsigned char Day;
}SysDate;

typedef struct
{
	LANGUAGE 	language;
	NUMTYPE		numtype;
	SysDate		sysdate;
	unsigned long	totalcnt;
	SYSLOOP sysloop;
	unsigned char isneedinitstage;
	unsigned char isinitsys;
	unsigned char isdpd;
}SysStruct;


typedef enum
{
	NULLKEY,
	SHORTKEY,
	LONGKEY_2S,
	LONGKEY_5S,
	LONGKEY_12S,
}KEYTYPE;

typedef enum
{
	YES,
	NO,
}YN;

#define KEYINPUTMODE 	

#define GETKEY		SN_PMU->PMU_CTRL_b.WKP

#define BLINK_H		100
#define BLINK_L		100

#define POWER_CNT1	1000
#define POWER_CNT2	12000

#define MCU_SNC7312		1
