jianweizou/fun/(commit log)

2019-02-16 风扇-20190216
    [Common.obj, FontData.obj, I2C_EEPROM.obj, OLED.obj, STARTUP.obj, count.obj, dataflash.obj, i2c.obj]
2019-02-16 update: 1 motor pwm from low to high 2 fourth is stop motor 3 2s press will direct stop motor 4 RGB LED with motor pwm
    [STARTUP.obj, key.obj, led.obj, main.obj, motor.obj]
2019-02-24 layout v1.4 modify pwm ,key
    [STARTUP.obj, key.obj, led.obj, main.obj, motor.obj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]
2019-02-26 update fw for power ,motor dir
    [STARTUP.obj, key.obj, led.obj, main.obj, motor.obj]
2019-02-27 更新：电机从高速到低速，颜色为红，蓝，绿；初次上电电池电量显示问题
    [STARTUP.obj, key.obj, led.obj, main.obj, motor.obj]
2019-02-28 add uart & pwm adc
    [Common.obj, FontData.obj, I2C_EEPROM.obj, OLED.obj, PUTCHAR.obj, STARTUP.obj, count.obj, dataflash.obj]
2019-03-06 add 语音控制版本
    [风扇_V1.5.DRL, 风扇_V1.5.GBL, 风扇_V1.5.GBO, 风扇_V1.5.GBP, 风扇_V1.5.GBS, 风扇_V1.5.GKO, 风扇_V1.5.GTL, 风扇_V1.5.GTO]
2019-03-13 check powerdown current question is AMS1117-33 standby current to large
    [STARTUP.obj, key.obj, led.obj, main.obj, motor.obj]
2019-03-16 AMS1117-33V改为TPS76033 DPD0.23mA
    [Common.obj, FontData.obj, I2C_EEPROM.obj, OLED.obj, PUTCHAR.obj, STARTUP.obj, count.obj, dataflash.obj]
2019-03-21 remove fun vr laytou to fun_vr
    [风扇_V1.5.DRL, 风扇_V1.5.GBL, 风扇_V1.5.GBO, 风扇_V1.5.GBP, 风扇_V1.5.GBS, 风扇_V1.5.GKO, 风扇_V1.5.GTL, 风扇_V1.5.GTO]
2019-03-23 update EE with ICP/fun_20190323.hex
    [STARTUP.obj, key.obj, led.obj, main.obj, motor.obj]
2019-03-27 update layout v1.5:U3 TPS76033 & R25 500K
    [风扇_V1.5.DXF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]
2019-03-27 update V1.5 layout
    [风扇_V1.5.GBL, 风扇_V1.5.GBO, 风扇_V1.5.GBP, 风扇_V1.5.GBS, 风扇_V1.5.GKO, 风扇_V1.5.GTL, 风扇_V1.5.GTO, 风扇_V1.5.GTP]
2019-04-13 update layout 1.6
    [风扇_V1.6.DRL, 风扇_V1.6.GBL, 风扇_V1.6.GBO, 风扇_V1.6.GBP, 风扇_V1.6.GBS, 风扇_V1.6.GKO, 风扇_V1.6.GTL, 风扇_V1.6.GTO]
2019-04-22 resum LED to RGB-GND
    [风扇_V1.7.DXF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]
2019-04-22 rename 1.7
    [风扇_V1.7.DXF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]
2019-04-22 update fw
    [STARTUP.obj, key.obj, led.obj, main.obj, motor.obj]
2019-05-01 layout 1.8 ， modify fw
    [STARTUP.obj, key.obj, led.obj, main.obj, motor.obj, to 鄒生 main_board_pcb_20190411_v3.dxf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]
2019-05-21 add motor run flag
    [STARTUP.obj, key.obj, led.obj, main.obj, motor.obj]
2019-05-21 整理流程
    [STARTUP.obj, key.obj, led.obj, main.obj, motor.obj]
2019-05-22 更新堵转参数
    [STARTUP.obj, key.obj, led.obj, main.obj, motor.obj]
2019-05-25 commit v1.0
    [STARTUP.obj, key.obj, led.obj, main.obj, motor.obj]
2019-05-26 更新最终版本V1.0
    [STARTUP.obj, key.obj, led.obj, main.obj, motor.obj]
2019-05-30 最终版V1.1
    [STARTUP.obj, key.obj, led.obj, main.obj, motor.obj]
2019-06-03 最终版本V1.2
    [STARTUP.obj, key.obj, led.obj, main.obj, motor.obj]
2019-06-26 update new fw:change bat level adc value =max 0xCF0
    [STARTUP.obj, key.obj, led.obj, main.obj, motor.obj]
2019-07-20 code function is ok,need checkout layout
    [STARTUP.obj, key.obj, led.obj, main.obj, motor.obj, 风扇_V1.8.SchDoc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]
2019-09-28 commit layout v1.9
    [main.obj, 风扇_V1.9.DXF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]
